upenn-embedded/final-project-website-submission-f25-t24-f25-team-1-team_name/chess.X/queuelogs/debugtool.txt

1676 1764451541629 GEN4_TO_CONTROLLER_LOG:GEN4_CONNECT_INT_LOG Payload End
1676 1764451541629 NativeController::GetFirmwareInfo entry
1676 1764451541629 pro JtagIce3 [0x01] <<< 02 00 00 00 01 
1676 1764451541645 pro JtagIce3 [0x01] >>> 84 01 00 00 
1676 1764451541645 NativeController::getFirmwareVersion entry
1676 1764451541645 pro JtagIce3 [0x01] <<< 02 00 00 01 01 
1676 1764451541661 pro JtagIce3 [0x01] >>> 84 01 01 00 
1676 1764451541661 pro JtagIce3 [0x01] <<< 02 00 00 02 01 
1676 1764451541677 pro JtagIce3 [0x01] >>> 84 01 16 00 
1676 1764451541677 pro JtagIce3 [0x01] <<< 02 00 00 03 02 
1676 1764451541693 pro JtagIce3 [0x01] >>> 84 01 86 00 00 
1676 1764451541693 NativeController::getFirmwareVersion exit
1676 1764451541693 pro JtagIce3 [0x01] <<< 02 00 00 09 01 
1676 1764451541710 pro JtagIce3 [0x01] >>> 84 01 FF 00 
1676 1764451541710 NativeController::tryGetFPGAVersion entry
1676 1764451541710 pro JtagIce3 [0x01] <<< 02 00 00 10 01 
1676 1764451541726 pro JtagIce3 [0x01] >>> 84 01 00 11 
1676 1764451541726 pro JtagIce3 [0x01] <<< 02 00 00 11 01 
1676 1764451541741 pro JtagIce3 [0x01] >>> 84 01 00 11 
1676 1764451541741 pro JtagIce3 [0x01] <<< 02 00 00 12 01 
1676 1764451541758 pro JtagIce3 [0x01] >>> 84 01 00 11 
1676 1764451541758 NativeController::tryGetFPGAVersion exit
1676 1764451541758 NativeController::tryGetFPGAVersion exit with exception No value present
1676 1764451541758 pro JtagIce3 [0x01] <<< 02 00 00 06 01 
1676 1764451541774 pro JtagIce3 [0x01] >>> 84 01 01 00 
1676 1764451541774 pro JtagIce3 [0x01] <<< 02 00 00 07 01 
1676 1764451541790 pro JtagIce3 [0x01] >>> 84 01 00 00 
1676 1764451541790 pro JtagIce3 [0x01] <<< 02 00 00 0A 01 
1676 1764451541806 pro JtagIce3 [0x01] >>> 84 01 00 11 
1676 1764451541806 NativeController::GetFirmwareInfo exit
1676 1764451541806 GEN4_TO_CONTROLLER_LOG:GEN4_CONNECT_INT_LOG Post:GetFirmwareInfo
1676 1764451541806 GEN4_TO_CONTROLLER_LOG:GEN4_CONNECT_INT_LOG Return Value
1676 1764451541806 GEN4_TO_CONTROLLER_LOG:GEN4_CONNECT_INT_LOG FirmwareInfo: Values:
1676 1764451541806 GEN4_TO_CONTROLLER_LOG:GEN4_CONNECT_INT_LOG FirmwareInfo: boot = false, bootVer = 1.0.0 (0x01.0x00.0x00), apVer = 1.22.134 (0x01.0x16.0x86), fpgaVer = null, scriptVer = null, macAddress = , devID = 0, devID1 = 0, devSN0 = 0, devSN1 = 0, serialNumber = null, appCommitID = null, scriptCommitID = null, PCB_ID = 0
1676 1764451541806 GEN4_TO_CONTROLLER_LOG:GEN4_CONNECT_INT_LOG Return End
1676 1764451541806 GEN4_CONNECT_DIAGNOSTICS:ENTERING: com.microchip.mplab.mdbcore.RI4Tool.ConnectionHandler.CheckForFWUpdates()
1676 1764451541806 GEN4_CONNECT_DIAGNOSTICS:Created FirmwareUpdateHandler com.microchip.mplab.mdbcore.AtmelIceScripting.OperationHandlers.AIceScriptingFirmwareUpdateHandler@eac0c85

1676 1764451541811 GEN4_TO_CONTROLLER_LOG:GEN4_CONNECT_INT_LOG Pre:SetUpdateFirmwareInfo
1676 1764451541811 GEN4_TO_CONTROLLER_LOG:GEN4_CONNECT_INT_LOG Payload
1676 1764451541811 GEN4_TO_CONTROLLER_LOG:GEN4_CONNECT_INT_LOG UpdateFirmwareInfo: Values:
1676 1764451541811 GEN4_TO_CONTROLLER_LOG:GEN4_CONNECT_INT_LOG UpdateFirmwareInfo: license = , updateId = 255
1676 1764451541811 GEN4_TO_CONTROLLER_LOG:GEN4_CONNECT_INT_LOG Payload End
1676 1764451541811 GEN4_TO_CONTROLLER_LOG:GEN4_CONNECT_INT_LOG Post:SetUpdateFirmwareInfo
1676 1764451541811 GEN4_TO_CONTROLLER_LOG:GEN4_CONNECT_INT_LOG Return Value
1676 1764451541811 GEN4_TO_CONTROLLER_LOG:GEN4_CONNECT_INT_LOG none
1676 1764451541811 GEN4_TO_CONTROLLER_LOG:GEN4_CONNECT_INT_LOG Return End
1676 1764451541811 GEN4_CONNECT_DIAGNOSTICS:EXITING: com.microchip.mplab.mdbcore.RI4Tool.ConnectionHandler.CheckForFWUpdates()

1676 1764451541811 GEN4_TO_CONTROLLER_LOG:GEN4_CONNECT_INT_LOG Pre:SetPowerInfo
1676 1764451541811 GEN4_TO_CONTROLLER_LOG:GEN4_CONNECT_INT_LOG Payload
1676 1764451541811 GEN4_TO_CONTROLLER_LOG:GEN4_CONNECT_INT_LOG PowerInfo: Values:
1676 1764451541812 GEN4_TO_CONTROLLER_LOG:GEN4_CONNECT_INT_LOG PowerInfo: shotDownSystem = false, isToolPower = false, voltage = 5.000000, useVppFirst = false, useLowVoltageProgramming = true, useMaintainActivePower = false
1676 1764451541812 GEN4_TO_CONTROLLER_LOG:GEN4_CONNECT_INT_LOG Payload End
1676 1764451541812 NativeController::GetVoltageInfo entry
1676 1764451541812 pro JtagIce3 [0x01] <<< 02 00 01 00 02 
1676 1764451541830 pro JtagIce3 [0x01] >>> 84 01 88 13 00 
1676 1764451541830 pro JtagIce3 [0x01] <<< 02 00 01 20 02 
1676 1764451541845 pro JtagIce3 [0x01] >>> 84 01 00 00 11 
1676 1764451541845 NativeController::GetVoltageInfo TSUP exit with exception + The requested command is not supported. (17)
1676 1764451541845 pro JtagIce3 [0x01] <<< 02 00 01 02 02 
1676 1764451541861 pro JtagIce3 [0x01] >>> 84 01 00 00 11 
1676 1764451541861 NativeController::GetVoltageInfo VUSB exit with exception + The requested command is not supported. (17)
1676 1764451541861 NativeController::GetVoltageInfo exit
1676 1764451541861 GEN4_TO_CONTROLLER_LOG:GEN4_CONNECT_INT_LOG Post:SetPowerInfo
1676 1764451541861 GEN4_TO_CONTROLLER_LOG:GEN4_CONNECT_INT_LOG Return Value
1676 1764451541861 GEN4_TO_CONTROLLER_LOG:GEN4_CONNECT_INT_LOG none
1676 1764451541861 GEN4_TO_CONTROLLER_LOG:GEN4_CONNECT_INT_LOG Return End

1676 1764451541861 GEN4_TO_CONTROLLER_LOG:GEN4_CONNECT_INT_LOG Pre:GetVoltageInfo
1676 1764451541861 GEN4_TO_CONTROLLER_LOG:GEN4_CONNECT_INT_LOG Payload
1676 1764451541861 GEN4_TO_CONTROLLER_LOG:GEN4_CONNECT_INT_LOG null
1676 1764451541861 GEN4_TO_CONTROLLER_LOG:GEN4_CONNECT_INT_LOG Payload End
1676 1764451541861 NativeController::GetVoltageInfo entry
1676 1764451541861 pro JtagIce3 [0x01] <<< 02 00 01 00 02 
1676 1764451541877 pro JtagIce3 [0x01] >>> 84 01 88 13 00 
1676 1764451541877 pro JtagIce3 [0x01] <<< 02 00 01 20 02 
1676 1764451541894 pro JtagIce3 [0x01] >>> 84 01 00 00 11 
1676 1764451541894 NativeController::GetVoltageInfo TSUP exit with exception + The requested command is not supported. (17)
1676 1764451541894 pro JtagIce3 [0x01] <<< 02 00 01 02 02 
1676 1764451541909 pro JtagIce3 [0x01] >>> 84 01 00 00 11 
1676 1764451541909 NativeController::GetVoltageInfo VUSB exit with exception + The requested command is not supported. (17)
1676 1764451541909 NativeController::GetVoltageInfo exit
1676 1764451541909 GEN4_TO_CONTROLLER_LOG:GEN4_CONNECT_INT_LOG Post:GetVoltageInfo
1676 1764451541909 GEN4_TO_CONTROLLER_LOG:GEN4_CONNECT_INT_LOG Return Value
1676 1764451541909 GEN4_TO_CONTROLLER_LOG:GEN4_CONNECT_INT_LOG VoltagesInfo: Values:
1676 1764451541909 GEN4_TO_CONTROLLER_LOG:GEN4_CONNECT_INT_LOG VoltagesInfo: internalVdd = 0, internalVpp = 0, targetVdd = 0, targetVpp = -2147483648, vddSense = 5000, temp = 0, vddCurrentSense = 0, vddVoltageSense = -2147483648
1676 1764451541909 GEN4_TO_CONTROLLER_LOG:GEN4_CONNECT_INT_LOG Return End

1676 1764451541909 GEN4_TO_CONTROLLER_LOG:GEN4_CONNECT_INT_LOG Pre:SetLEDBrightness
1676 1764451541909 GEN4_TO_CONTROLLER_LOG:GEN4_CONNECT_INT_LOG Payload
1676 1764451541909 GEN4_TO_CONTROLLER_LOG:GEN4_CONNECT_INT_LOG 5
1676 1764451541909 GEN4_TO_CONTROLLER_LOG:GEN4_CONNECT_INT_LOG Payload End
1676 1764451541909 GEN4_TO_CONTROLLER_LOG:GEN4_CONNECT_INT_LOG Post:SetLEDBrightness
1676 1764451541909 GEN4_TO_CONTROLLER_LOG:GEN4_CONNECT_INT_LOG Return Value
1676 1764451541909 GEN4_TO_CONTROLLER_LOG:GEN4_CONNECT_INT_LOG none
1676 1764451541909 GEN4_TO_CONTROLLER_LOG:GEN4_CONNECT_INT_LOG Return End

1676 1764451541909 GEN4_TO_CONTROLLER_LOG:GEN4_CONNECT_INT_LOG Pre:SetToolInfo
1676 1764451541909 GEN4_TO_CONTROLLER_LOG:GEN4_CONNECT_INT_LOG Payload
1676 1764451541909 GEN4_TO_CONTROLLER_LOG:GEN4_CONNECT_INT_LOG ToolInfo: Values:
1676 1764451541909 GEN4_TO_CONTROLLER_LOG:GEN4_CONNECT_INT_LOG ToolInfo: speedLevel = 1, PGCResistance = 4700, PGDResistance = 4700, PGCPullDir = PullDown, PGDPullDir = PullDown, ICSPSelected = Wire2
1676 1764451541909 GEN4_TO_CONTROLLER_LOG:GEN4_CONNECT_INT_LOG Payload End
1676 1764451541909 GEN4_TO_CONTROLLER_LOG:GEN4_CONNECT_INT_LOG Post:SetToolInfo
1676 1764451541909 GEN4_TO_CONTROLLER_LOG:GEN4_CONNECT_INT_LOG Return Value
1676 1764451541909 GEN4_TO_CONTROLLER_LOG:GEN4_CONNECT_INT_LOG none
1676 1764451541909 GEN4_TO_CONTROLLER_LOG:GEN4_CONNECT_INT_LOG Return End

1676 1764451541910 GEN4_TO_CONTROLLER_LOG:GEN4_CONNECT_INT_LOG Pre:GetTargetIDInfo
1676 1764451541910 GEN4_TO_CONTROLLER_LOG:GEN4_CONNECT_INT_LOG Payload
1676 1764451541910 GEN4_TO_CONTROLLER_LOG:GEN4_CONNECT_INT_LOG null
1676 1764451541910 GEN4_TO_CONTROLLER_LOG:GEN4_CONNECT_INT_LOG Payload End
1676 1764451541910 NativeController::GetTargetIDInfo entry
1676 1764451541910 pro JtagIce3 [0x12] <<< 01 00 00 00 01 01 
1676 1764451541925 pro JtagIce3 [0x12] >>> 80 00 
1676 1764451541925 pro JtagIce3 [0x12] <<< 01 00 00 01 04 01 00 00 00 
1676 1764451541941 pro JtagIce3 [0x12] >>> 80 00 
1676 1764451541941 pro JtagIce3 [0x12] <<< 01 00 01 00 01 01 
1676 1764451541958 pro JtagIce3 [0x12] >>> 80 00 
1676 1764451541958 pro JtagIce3 [0x11] <<< 1D 7D 00 
1676 1764451541974 pro JtagIce3 [0x11] >>> 1D 00 
1676 1764451541974 pro JtagIce3 [0x11] <<< 10 C8 64 19 20 00 53 03 AC 53 00 00 
1676 1764451542077 pro JtagIce3 [0x11] >>> 10 00 
1676 1764451542077 pro JtagIce3 [0x11] <<< 1B 04 30 00 00 00 
1676 1764451542094 pro JtagIce3 [0x11] >>> 1B 00 1E 00 
1676 1764451542094 pro JtagIce3 [0x11] <<< 1B 04 30 00 01 00 
1676 1764451542110 pro JtagIce3 [0x11] >>> 1B 00 95 00 
1676 1764451542110 pro JtagIce3 [0x11] <<< 1B 04 30 00 02 00 
1676 1764451542125 pro JtagIce3 [0x11] >>> 1B 00 16 00 
1676 1764451542125 pro JtagIce3 [0x11] <<< 1B 04 30 00 00 00 
1676 1764451542141 pro JtagIce3 [0x11] >>> 1B 00 1E 00 
1676 1764451542141 pro JtagIce3 [0x11] <<< 1B 04 30 00 01 00 
1676 1764451542158 pro JtagIce3 [0x11] >>> 1B 00 95 00 
1676 1764451542158 pro JtagIce3 [0x11] <<< 1B 04 30 00 02 00 
1676 1764451542173 pro JtagIce3 [0x11] >>> 1B 00 16 00 
1676 1764451542173 pro JtagIce3 [0x11] <<< 1B 04 30 00 00 00 
1676 1764451542190 pro JtagIce3 [0x11] >>> 1B 00 1E 00 
1676 1764451542190 pro JtagIce3 [0x11] <<< 1B 04 30 00 01 00 
1676 1764451542206 pro JtagIce3 [0x11] >>> 1B 00 95 00 
1676 1764451542206 pro JtagIce3 [0x11] <<< 1B 04 30 00 02 00 
1676 1764451542222 pro JtagIce3 [0x11] >>> 1B 00 16 00 
1676 1764451542222 pro JtagIce3 [0x11] <<< 11 01 01 
1676 1764451542238 pro JtagIce3 [0x11] >>> 11 00 
1676 1764451542238 pro JtagIce3 [0x01] <<< 11 00 00 
1676 1764451542254 pro JtagIce3 [0x01] >>> 80 00 
1676 1764451542254 NativeController::GetTargetIDInfo exit device ID 0x1e9516
1676 1764451542254 GEN4_TO_CONTROLLER_LOG:GEN4_CONNECT_INT_LOG Post:GetTargetIDInfo
1676 1764451542254 GEN4_TO_CONTROLLER_LOG:GEN4_CONNECT_INT_LOG Return Value
1676 1764451542254 GEN4_TO_CONTROLLER_LOG:GEN4_CONNECT_INT_LOG TargetIDInfo: Values:
1676 1764451542254 GEN4_TO_CONTROLLER_LOG:GEN4_CONNECT_INT_LOG TargetIDInfo: DeviceID = 001e9516
1676 1764451542254 GEN4_TO_CONTROLLER_LOG:GEN4_CONNECT_INT_LOG Return End

1676 1764451542260 GEN4_TO_CONTROLLER_LOG:GEN4_PROGRAM_INT_LOG_ATmega328PB Pre:SendOperation
1676 1764451542260 GEN4_TO_CONTROLLER_LOG:GEN4_PROGRAM_INT_LOG_ATmega328PB Payload
1676 1764451542260 GEN4_TO_CONTROLLER_LOG:GEN4_PROGRAM_INT_LOG_ATmega328PB OperationInfo: Values:
1676 1764451542260 GEN4_TO_CONTROLLER_LOG:GEN4_PROGRAM_INT_LOG_ATmega328PB OperationInfo: Type = erase, Mask = 00000000, Erase = false, Production Mode = true
1676 1764451542260 GEN4_TO_CONTROLLER_LOG:GEN4_PROGRAM_INT_LOG_ATmega328PB TransferInfo: Start = 0, End = 7fff, Buffer Length = 0, Type = Pgm, Mask = 00000000
1676 1764451542260 GEN4_TO_CONTROLLER_LOG:GEN4_PROGRAM_INT_LOG_ATmega328PB TransferInfo: Start = 820000, End = 820002, Buffer Length = 0, Type = Cfg, Mask = 00000000
1676 1764451542260 GEN4_TO_CONTROLLER_LOG:GEN4_PROGRAM_INT_LOG_ATmega328PB TransferInfo: Start = 830000, End = 830000, Buffer Length = 0, Type = Cfg, Mask = 00000000
1676 1764451542260 GEN4_TO_CONTROLLER_LOG:GEN4_PROGRAM_INT_LOG_ATmega328PB TransferInfo: Start = 0, End = 3ff, Buffer Length = 0, Type = DataFlash, Mask = 00000000
1676 1764451542260 GEN4_TO_CONTROLLER_LOG:GEN4_PROGRAM_INT_LOG_ATmega328PB Payload End
1676 1764451542260 pro JtagIce3 [0x12] <<< 01 00 00 00 01 01 
1676 1764451542277 pro JtagIce3 [0x12] >>> 80 00 
1676 1764451542277 pro JtagIce3 [0x12] <<< 01 00 00 01 04 01 00 00 00 
1676 1764451542293 pro JtagIce3 [0x12] >>> 80 00 
1676 1764451542293 pro JtagIce3 [0x12] <<< 01 00 01 00 01 01 
1676 1764451542309 pro JtagIce3 [0x12] >>> 80 00 
1676 1764451542309 pro JtagIce3 [0x11] <<< 1D 7D 00 
1676 1764451542325 pro JtagIce3 [0x11] >>> 1D 00 
1676 1764451542325 pro JtagIce3 [0x11] <<< 10 C8 64 19 20 00 53 03 AC 53 00 00 
1676 1764451542430 pro JtagIce3 [0x11] >>> 10 00 
1676 1764451542430 pro JtagIce3 [0x11] <<< 1B 04 30 00 00 00 
1676 1764451542445 pro JtagIce3 [0x11] >>> 1B 00 1E 00 
1676 1764451542445 pro JtagIce3 [0x11] <<< 1B 04 30 00 01 00 
1676 1764451542461 pro JtagIce3 [0x11] >>> 1B 00 95 00 
1676 1764451542461 pro JtagIce3 [0x11] <<< 1B 04 30 00 02 00 
1676 1764451542477 pro JtagIce3 [0x11] >>> 1B 00 16 00 
1676 1764451542477 pro JtagIce3 [0x11] <<< 12 2D 01 AC 80 00 00 
1676 1764451542493 pro JtagIce3 [0x11] >>> 12 00 
1676 1764451542493 pro JtagIce3 [0x11] <<< 18 04 58 08 00 00 
1676 1764451542509 pro JtagIce3 [0x11] >>> 18 00 DF 00 
1676 1764451542560 pro JtagIce3 [0x11] <<< 17 AC A8 00 DF 
1676 1764451542573 pro JtagIce3 [0x11] >>> 17 00 
1676 1764451542599 pro JtagIce3 [0x11] <<< 12 2D 01 AC 80 00 00 
1676 1764451542613 pro JtagIce3 [0x11] >>> 12 00 
1676 1764451542613 GEN4_TO_CONTROLLER_LOG:GEN4_PROGRAM_INT_LOG_ATmega328PB Post:SendOperation
1676 1764451542613 GEN4_TO_CONTROLLER_LOG:GEN4_PROGRAM_INT_LOG_ATmega328PB Return Value
1676 1764451542613 GEN4_TO_CONTROLLER_LOG:GEN4_PROGRAM_INT_LOG_ATmega328PB None
1676 1764451542613 GEN4_TO_CONTROLLER_LOG:GEN4_PROGRAM_INT_LOG_ATmega328PB Return End

1676 1764451542614 GEN4_TO_CONTROLLER_LOG:GEN4_PROGRAM_INT_LOG_ATmega328PB Pre:SendOperation
1676 1764451542614 GEN4_TO_CONTROLLER_LOG:GEN4_PROGRAM_INT_LOG_ATmega328PB Payload
1676 1764451542614 GEN4_TO_CONTROLLER_LOG:GEN4_PROGRAM_INT_LOG_ATmega328PB OperationInfo: Values:
1676 1764451542614 GEN4_TO_CONTROLLER_LOG:GEN4_PROGRAM_INT_LOG_ATmega328PB OperationInfo: Type = write, Mask = 00000000, Erase = false, Production Mode = true
1676 1764451542614 GEN4_TO_CONTROLLER_LOG:GEN4_PROGRAM_INT_LOG_ATmega328PB TransferInfo: Start = 0, End = 1d7f, Buffer Length = 7552, Type = Pgm, Mask = 00000000
1676 1764451542614 GEN4_TO_CONTROLLER_LOG:GEN4_PROGRAM_INT_LOG_ATmega328PB Payload End
1676 1764451542614 pro JtagIce3 [0x11] <<< 06 00 00 00 00 
1676 1764451542629 pro JtagIce3 [0x11] >>> 06 00 
1676 1764451542629 pro JtagIce3 [0x11] <<< 13 00 80 C1 0A 40 4C 20 00 00 0C 94 7B 00 0C 94 78 0C 0C 94 89 0C 0C 94 55 0D 0C 94 55 0D 0C 94 55 0D 0C 94 55 0D 0C 94 55 0D 0C 94 55 0D 0C 94 55 0D 0C 94 55 0D 0C 94 3B 09 0C 94 55 0D 0C 94 55 0D 0C 94 55 0D 0C 94 55 0D 0C 94 55 0D 0C 94 55 0D 0C 94 55 0D 0C 94 55 0D 0C 94 55 0D 0C 94 55 0D 0C 94 55 0D 0C 94 55 0D 0C 94 55 0D 0C 94 55 0D 0C 94 55 0D 0C 94 55 0D 0C 94 55 0D 0C 94 55 0D 0C 94 55 0D 0C 94 55 0D 
1676 1764451542732 pro JtagIce3 [0x11] >>> 13 00 
1676 1764451542732 pro JtagIce3 [0x11] <<< 06 00 00 00 40 
1676 1764451542748 pro JtagIce3 [0x11] >>> 06 00 
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
1676 1764451556590 GEN4_TO_CONTROLLER_LOG:GEN4_PROGRAM_INT_LOG_ATmega328PB Return Value
1676 1764451556590 GEN4_TO_CONTROLLER_LOG:GEN4_PROGRAM_INT_LOG_ATmega328PB None
1676 1764451556590 GEN4_TO_CONTROLLER_LOG:GEN4_PROGRAM_INT_LOG_ATmega328PB Return End

1676 1764451556590 GEN4_TO_CONTROLLER_LOG:GEN4_PROGRAM_INT_LOG_ATmega328PB Pre:endOfOperations
1676 1764451556590 GEN4_TO_CONTROLLER_LOG:GEN4_PROGRAM_INT_LOG_ATmega328PB Payload
1676 1764451556590 GEN4_TO_CONTROLLER_LOG:GEN4_PROGRAM_INT_LOG_ATmega328PB null
1676 1764451556590 GEN4_TO_CONTROLLER_LOG:GEN4_PROGRAM_INT_LOG_ATmega328PB Payload End
1676 1764451556590 pro JtagIce3 [0x11] <<< 11 01 01 
1676 1764451556605 pro JtagIce3 [0x11] >>> 11 00 
1676 1764451556605 pro JtagIce3 [0x01] <<< 11 00 00 
1676 1764451556622 pro JtagIce3 [0x01] >>> 80 00 
1676 1764451556622 GEN4_TO_CONTROLLER_LOG:GEN4_PROGRAM_INT_LOG_ATmega328PB Post:endOfOperations
1676 1764451556622 GEN4_TO_CONTROLLER_LOG:GEN4_PROGRAM_INT_LOG_ATmega328PB Return Value
1676 1764451556622 GEN4_TO_CONTROLLER_LOG:GEN4_PROGRAM_INT_LOG_ATmega328PB None
1676 1764451556622 GEN4_TO_CONTROLLER_LOG:GEN4_PROGRAM_INT_LOG_ATmega328PB Return End

1676 1764451556623 GEN4_TO_CONTROLLER_LOG:GEN4_PROGRAM_INT_LOG_ATmega328PB Pre:SendOperation
1676 1764451556623 GEN4_TO_CONTROLLER_LOG:GEN4_PROGRAM_INT_LOG_ATmega328PB Payload
1676 1764451556623 GEN4_TO_CONTROLLER_LOG:GEN4_PROGRAM_INT_LOG_ATmega328PB OperationInfo: Values:
1676 1764451556623 GEN4_TO_CONTROLLER_LOG:GEN4_PROGRAM_INT_LOG_ATmega328PB OperationInfo: Type = releasefromreset, Mask = 00000000, Erase = false, Production Mode = true
1676 1764451556623 GEN4_TO_CONTROLLER_LOG:GEN4_PROGRAM_INT_LOG_ATmega328PB Payload End
1676 1764451556623 pro JtagIce3 [0x01] <<< 11 00 00 
1676 1764451556638 pro JtagIce3 [0x01] >>> 80 00 
1676 1764451556638 GEN4_TO_CONTROLLER_LOG:GEN4_PROGRAM_INT_LOG_ATmega328PB Post:SendOperation
1676 1764451556638 GEN4_TO_CONTROLLER_LOG:GEN4_PROGRAM_INT_LOG_ATmega328PB Return Value
1676 1764451556638 GEN4_TO_CONTROLLER_LOG:GEN4_PROGRAM_INT_LOG_ATmega328PB None
1676 1764451556638 GEN4_TO_CONTROLLER_LOG:GEN4_PROGRAM_INT_LOG_ATmega328PB Return End
1676 1764451556638 GEN4_CONNECT_DIAGNOSTICS:MPLABCommTool is null

1676 1764451556638 GEN4_TO_CONTROLLER_LOG:GEN4_CONNECT_INT_LOG Pre:GetFirmwareInfo
1676 1764451556638 GEN4_TO_CONTROLLER_LOG:GEN4_CONNECT_INT_LOG Payload
1676 1764451556638 GEN4_TO_CONTROLLER_LOG:GEN4_CONNECT_INT_LOG null
1676 1764451556638 GEN4_TO_CONTROLLER_LOG:GEN4_CONNECT_INT_LOG Payload End
1676 1764451556638 NativeController::GetFirmwareInfo entry
1676 1764451556638 pro JtagIce3 [0x01] <<< 02 00 00 00 01 
1676 1764451556654 pro JtagIce3 [0x01] >>> 84 01 00 00 
1676 1764451556654 NativeController::getFirmwareVersion entry
1676 1764451556654 pro JtagIce3 [0x01] <<< 02 00 00 01 01 
1676 1764451556669 pro JtagIce3 [0x01] >>> 84 01 01 00 
1676 1764451556669 pro JtagIce3 [0x01] <<< 02 00 00 02 01 
1676 1764451556686 pro JtagIce3 [0x01] >>> 84 01 16 00 
1676 1764451556686 pro JtagIce3 [0x01] <<< 02 00 00 03 02 
1676 1764451556702 pro JtagIce3 [0x01] >>> 84 01 86 00 00 
1676 1764451556702 NativeController::getFirmwareVersion exit
1676 1764451556702 pro JtagIce3 [0x01] <<< 02 00 00 09 01 
1676 1764451556717 pro JtagIce3 [0x01] >>> 84 01 FF 00 
1676 1764451556717 NativeController::tryGetFPGAVersion entry
1676 1764451556717 pro JtagIce3 [0x01] <<< 02 00 00 10 01 
1676 1764451556733 pro JtagIce3 [0x01] >>> 84 01 00 11 
1676 1764451556733 pro JtagIce3 [0x01] <<< 02 00 00 11 01 
1676 1764451556749 pro JtagIce3 [0x01] >>> 84 01 00 11 
1676 1764451556749 pro JtagIce3 [0x01] <<< 02 00 00 12 01 
1676 1764451556765 pro JtagIce3 [0x01] >>> 84 01 00 11 
1676 1764451556765 NativeController::tryGetFPGAVersion exit
1676 1764451556765 NativeController::tryGetFPGAVersion exit with exception No value present
1676 1764451556765 pro JtagIce3 [0x01] <<< 02 00 00 06 01 
1676 1764451556782 pro JtagIce3 [0x01] >>> 84 01 01 00 
1676 1764451556782 pro JtagIce3 [0x01] <<< 02 00 00 07 01 
1676 1764451556798 pro JtagIce3 [0x01] >>> 84 01 00 00 
1676 1764451556798 pro JtagIce3 [0x01] <<< 02 00 00 0A 01 
1676 1764451556813 pro JtagIce3 [0x01] >>> 84 01 00 11 
1676 1764451556814 NativeController::GetFirmwareInfo exit
1676 1764451556814 GEN4_TO_CONTROLLER_LOG:GEN4_CONNECT_INT_LOG Post:GetFirmwareInfo
1676 1764451556814 GEN4_TO_CONTROLLER_LOG:GEN4_CONNECT_INT_LOG Return Value
1676 1764451556814 GEN4_TO_CONTROLLER_LOG:GEN4_CONNECT_INT_LOG FirmwareInfo: Values:
1676 1764451556814 GEN4_TO_CONTROLLER_LOG:GEN4_CONNECT_INT_LOG FirmwareInfo: boot = false, bootVer = 1.0.0 (0x01.0x00.0x00), apVer = 1.22.134 (0x01.0x16.0x86), fpgaVer = null, scriptVer = null, macAddress = , devID = 0, devID1 = 0, devSN0 = 0, devSN1 = 0, serialNumber = null, appCommitID = null, scriptCommitID = null, PCB_ID = 0
1676 1764451556814 GEN4_TO_CONTROLLER_LOG:GEN4_CONNECT_INT_LOG Return End

1676 1764451556814 GEN4_TO_CONTROLLER_LOG:GEN4_CONNECT_INT_LOG Pre:SetPowerInfo
1676 1764451556814 GEN4_TO_CONTROLLER_LOG:GEN4_CONNECT_INT_LOG Payload
1676 1764451556814 GEN4_TO_CONTROLLER_LOG:GEN4_CONNECT_INT_LOG PowerInfo: Values:
1676 1764451556814 GEN4_TO_CONTROLLER_LOG:GEN4_CONNECT_INT_LOG PowerInfo: shotDownSystem = true, isToolPower = false, voltage = 0.000000, useVppFirst = false, useLowVoltageProgramming = true, useMaintainActivePower = false
1676 1764451556814 GEN4_TO_CONTROLLER_LOG:GEN4_CONNECT_INT_LOG Payload End
1676 1764451556814 NativeController::GetVoltageInfo entry
1676 1764451556814 pro JtagIce3 [0x01] <<< 02 00 01 00 02 
1676 1764451556830 pro JtagIce3 [0x01] >>> 84 01 88 13 00 
1676 1764451556830 pro JtagIce3 [0x01] <<< 02 00 01 20 02 
1676 1764451556846 pro JtagIce3 [0x01] >>> 84 01 00 00 11 
1676 1764451556846 NativeController::GetVoltageInfo TSUP exit with exception + The requested command is not supported. (17)
1676 1764451556846 pro JtagIce3 [0x01] <<< 02 00 01 02 02 
1676 1764451556861 pro JtagIce3 [0x01] >>> 84 01 00 00 11 
1676 1764451556861 NativeController::GetVoltageInfo VUSB exit with exception + The requested command is not supported. (17)
1676 1764451556861 NativeController::GetVoltageInfo exit
1676 1764451556861 GEN4_TO_CONTROLLER_LOG:GEN4_CONNECT_INT_LOG Post:SetPowerInfo
1676 1764451556861 GEN4_TO_CONTROLLER_LOG:GEN4_CONNECT_INT_LOG Return Value
1676 1764451556861 GEN4_TO_CONTROLLER_LOG:GEN4_CONNECT_INT_LOG none
1676 1764451556861 GEN4_TO_CONTROLLER_LOG:GEN4_CONNECT_INT_LOG Return End

1676 1764451556861 GEN4_TO_CONTROLLER_LOG:GEN4_CONNECT_INT_LOG Pre:Disconnect
1676 1764451556861 GEN4_TO_CONTROLLER_LOG:GEN4_CONNECT_INT_LOG Payload
1676 1764451556861 GEN4_TO_CONTROLLER_LOG:GEN4_CONNECT_INT_LOG Payload End
1676 1764451556861 NativeController::Disconnect entry
1676 1764451556861 pro JtagIce3 [0x01] <<< 11 00 00 
1676 1764451556878 pro JtagIce3 [0x01] >>> 80 00 
1676 1764451556878 NativeController::Disconnect exit
1676 1764451556878 GEN4_TO_CONTROLLER_LOG:GEN4_CONNECT_INT_LOG Post:Disconnect
1676 1764451556878 GEN4_TO_CONTROLLER_LOG:GEN4_CONNECT_INT_LOG Return Value
1676 1764451556878 GEN4_TO_CONTROLLER_LOG:GEN4_CONNECT_INT_LOG none
1676 1764451556878 GEN4_TO_CONTROLLER_LOG:GEN4_CONNECT_INT_LOG Return End
1676 1764451556878 GEN4_CONNECT_DIAGNOSTICS:Removing plug and play observer com.microchip.mplab.mdbcore.RI4Tool.RI4ToolBase$RI4PlugNPlayObserver@555a89df
1676 1764451556878 GEN4_CONNECT_DIAGNOSTICS:Begin PlugNPlayObservers list dump:
1676 1764451556878 GEN4_CONNECT_DIAGNOSTICS:End PlugNPlayObservers list dump:
1676 1764451556979 GEN4_CONNECT_DIAGNOSTICS:Calling RIDbgToolCom.Disconnect
1676 1764451556979 GEN4_CONNECT_DIAGNOSTICS:Calling MPLABCommTool.Detach to remove tool from plug and play list
1676 1764451556979 GEN4_CONNECT_DIAGNOSTICS:Calling RIDbgToolCom.DisconnectFromMPlabComm
1676 1764451556979 GEN4_CONNECT_DIAGNOSTICS:Calling MPLABCommTool.Disconnect
1722 1764452234338 GEN4_CONNECT_DIAGNOSTICS:MPLABCommTool is NOT null
1722 1764452234338 GEN4_CONNECT_DIAGNOSTICS:AttachedToolPID = 2145, AttachedToolVID = 3eb
1722 1764452234338 GEN4_CONNECT_DIAGNOSTICS:transport type = USB
1722 1764452234338 GEN4_CONNECT_DIAGNOSTICS:AttachedToolPID = 2145, AttachedToolVID = 3eb
1722 1764452234340 com.microchip.mplab.mdbcore.RealICETool.RIDbgToolCom
1722 1764452234340 GEN4_CONNECT_DIAGNOSTICS:Before MPLABCommTool.Connect()
1722 1764452234340 GEN4_CONNECT_DIAGNOSTICS:After MPLABCommTool.Connect()
1722 1764452234340 GEN4_CONNECT_DIAGNOSTICS:MPLABCommTool.Connect() returned MPLABCOMM_NO_ERROR
1722 1764452234340 GEN4_CONNECT_DIAGNOSTICS:Attaching to MPLABCommTool plugnplay
1722 1764452234340 GEN4_CONNECT_DIAGNOSTICS:Adding new plug and play observer com.microchip.mplab.mdbcore.RI4Tool.RI4ToolBase$RI4PlugNPlayObserver@fc8a47b
1722 1764452234340 GEN4_CONNECT_DIAGNOSTICS:Begin PlugNPlayObservers list dump:
1722 1764452234340 GEN4_CONNECT_DIAGNOSTICS:com.microchip.mplab.mdbcore.RI4Tool.RI4ToolBase$RI4PlugNPlayObserver@fc8a47b
1722 1764452234340 GEN4_CONNECT_DIAGNOSTICS:End PlugNPlayObservers list dump:
1722 1764452234340 GEN4_CONNECT_DIAGNOSTICS:Registering for alternate PNP notifications. CommPnPCriteria.cPIDList = [2ff4], CommPnPCriteria.cSerialNumber = atml2523052700011486

1722 1764452234355 GEN4_TO_CONTROLLER_LOG:GEN4_INIT_INT_LOG_ATmega328PB Pre:init
1722 1764452234355 GEN4_TO_CONTROLLER_LOG:GEN4_INIT_INT_LOG_ATmega328PB Payload
1722 1764452234355 GEN4_TO_CONTROLLER_LOG:GEN4_INIT_INT_LOG_ATmega328PB DeviceInfo: Values:
1722 1764452234355 GEN4_TO_CONTROLLER_LOG:GEN4_INIT_INT_LOG_ATmega328PB DeviceInfo: pcAddress = 7fffffffffffffff, Vpp = 5.00, useRowEraseIfVoltageIsLow = false, voltageBelowWhichUseRowErase = 0.00, deviceName = ATmega328PB, programmerType = 
1722 1764452234355 GEN4_TO_CONTROLLER_LOG:GEN4_INIT_INT_LOG_ATmega328PB DeviceInfo: MemInfo values:
1722 1764452234355 GEN4_TO_CONTROLLER_LOG:GEN4_INIT_INT_LOG_ATmega328PB DeviceInfo: mask = ffff, exists = true, startAddr = 00000000, endAddr = 00007fff, rowSize = 0080, rowEraseSize = 0080, addrInc = 0001, widthProgram = 0001
1722 1764452234355 GEN4_TO_CONTROLLER_LOG:GEN4_INIT_INT_LOG_ATmega328PB DeviceInfo: mask = 00ff, exists = true, startAddr = 00820000, endAddr = 00820002, rowSize = 0001, rowEraseSize = 0000, addrInc = 0001, widthProgram = 0001
1722 1764452234355 GEN4_TO_CONTROLLER_LOG:GEN4_INIT_INT_LOG_ATmega328PB DeviceInfo: mask = 0000, exists = false, startAddr = 00000000, endAddr = 00000000, rowSize = 0000, rowEraseSize = 0000, addrInc = 0000, widthProgram = 0000
1722 1764452234355 GEN4_TO_CONTROLLER_LOG:GEN4_INIT_INT_LOG_ATmega328PB DeviceInfo: mask = 0000, exists = false, startAddr = 00000000, endAddr = 00000000, rowSize = 0000, rowEraseSize = 0000, addrInc = 0000, widthProgram = 0000
1722 1764452234355 GEN4_TO_CONTROLLER_LOG:GEN4_INIT_INT_LOG_ATmega328PB DeviceInfo: mask = 0000, exists = false, startAddr = 00000000, endAddr = 00000000, rowSize = 0000, rowEraseSize = 0000, addrInc = 0000, widthProgram = 0000
1722 1764452234355 GEN4_TO_CONTROLLER_LOG:GEN4_INIT_INT_LOG_ATmega328PB DeviceInfo: mask = 0000, exists = false, startAddr = 00000000, endAddr = 00000000, rowSize = 0000, rowEraseSize = 0080, addrInc = 0000, widthProgram = 0000
1722 1764452234355 GEN4_TO_CONTROLLER_LOG:GEN4_INIT_INT_LOG_ATmega328PB DeviceInfo: mask = 0000, exists = false, startAddr = 00000000, endAddr = 00000000, rowSize = 0000, rowEraseSize = 0000, addrInc = 0001, widthProgram = 0001
1722 1764452234355 GEN4_TO_CONTROLLER_LOG:GEN4_INIT_INT_LOG_ATmega328PB DeviceInfo: mask = 0000, exists = false, startAddr = 00000000, endAddr = 00000000, rowSize = 0000, rowEraseSize = 0000, addrInc = 0000, widthProgram = 0000
1722 1764452234355 GEN4_TO_CONTROLLER_LOG:GEN4_INIT_INT_LOG_ATmega328PB DeviceInfo: mask = 00ff, exists = true, startAddr = 00000000, endAddr = 000003ff, rowSize = 0004, rowEraseSize = 0000, addrInc = 0001, widthProgram = 0001
1722 1764452234355 GEN4_TO_CONTROLLER_LOG:GEN4_INIT_INT_LOG_ATmega328PB DeviceInfo: mask = 0000, exists = false, startAddr = 00000000, endAddr = 00000000, rowSize = 0000, rowEraseSize = 0000, addrInc = 0000, widthProgram = 0000
1722 1764452234355 GEN4_TO_CONTROLLER_LOG:GEN4_INIT_INT_LOG_ATmega328PB DeviceInfo: mask = 0000, exists = false, startAddr = 00000000, endAddr = 00000000, rowSize = 0000, rowEraseSize = 0000, addrInc = 0000, widthProgram = 0000
1722 1764452234356 GEN4_TO_CONTROLLER_LOG:GEN4_INIT_INT_LOG_ATmega328PB DeviceInfo: mask = 0000, exists = false, startAddr = 00000000, endAddr = 00000000, rowSize = 0000, rowEraseSize = 0000, addrInc = 0001, widthProgram = 0001
1722 1764452234356 GEN4_TO_CONTROLLER_LOG:GEN4_INIT_INT_LOG_ATmega328PB DeviceInfo: mask = 0000, exists = false, startAddr = 00000000, endAddr = 00000000, rowSize = 0000, rowEraseSize = 0000, addrInc = 0000, widthProgram = 0000
1722 1764452234356 GEN4_TO_CONTROLLER_LOG:GEN4_INIT_INT_LOG_ATmega328PB DeviceInfo: mask = 0000, exists = false, startAddr = 00000000, endAddr = 00000000, rowSize = 0000, rowEraseSize = 0000, addrInc = 0000, widthProgram = 0000
1722 1764452234356 GEN4_TO_CONTROLLER_LOG:GEN4_INIT_INT_LOG_ATmega328PB DeviceInfo: mask = 0000, exists = false, startAddr = 00000000, endAddr = 00000000, rowSize = 0000, rowEraseSize = 0000, addrInc = 0000, widthProgram = 0000
1722 1764452234356 GEN4_TO_CONTROLLER_LOG:GEN4_INIT_INT_LOG_ATmega328PB DeviceInfo: mask = 0000, exists = false, startAddr = 00000000, endAddr = 00000000, rowSize = 0000, rowEraseSize = 0000, addrInc = 0000, widthProgram = 0000
1722 1764452234356 GEN4_TO_CONTROLLER_LOG:GEN4_INIT_INT_LOG_ATmega328PB DeviceInfo: mask = 7fffffff, exists = true, startAddr = 00840000, endAddr = 00840002, rowSize = 0001, rowEraseSize = 0000, addrInc = 0001, widthProgram = 0001
1722 1764452234356 GEN4_TO_CONTROLLER_LOG:GEN4_INIT_INT_LOG_ATmega328PB DeviceInfo: mask = 0000, exists = false, startAddr = 00000000, endAddr = 00000000, rowSize = 0000, rowEraseSize = 0000, addrInc = 0000, widthProgram = 0000
1722 1764452234356 GEN4_TO_CONTROLLER_LOG:GEN4_INIT_INT_LOG_ATmega328PB DeviceInfo: mask = 0000, exists = false, startAddr = 00000000, endAddr = 00000000, rowSize = 0000, rowEraseSize = 0000, addrInc = 0000, widthProgram = 0000
1722 1764452234356 GEN4_TO_CONTROLLER_LOG:GEN4_INIT_INT_LOG_ATmega328PB DeviceInfo: mask = 0000, exists = false, startAddr = 00000000, endAddr = 00000000, rowSize = 0000, rowEraseSize = 0000, addrInc = 0000, widthProgram = 0000
1722 1764452234356 GEN4_TO_CONTROLLER_LOG:GEN4_INIT_INT_LOG_ATmega328PB DeviceInfo: mask = 0000, exists = false, startAddr = 00000000, endAddr = 00000000, rowSize = 0000, rowEraseSize = 0000, addrInc = 0000, widthProgram = 0000
1722 1764452234356 GEN4_TO_CONTROLLER_LOG:GEN4_INIT_INT_LOG_ATmega328PB DeviceInfo: mask = 0000, exists = false, startAddr = 00000000, endAddr = 00000000, rowSize = 0000, rowEraseSize = 0000, addrInc = 0000, widthProgram = 0000
1722 1764452234356 GEN4_TO_CONTROLLER_LOG:GEN4_INIT_INT_LOG_ATmega328PB DeviceInfo: mask = 0000, exists = false, startAddr = 00000000, endAddr = 00000000, rowSize = 0000, rowEraseSize = 0000, addrInc = 0000, widthProgram = 0000
1722 1764452234356 GEN4_TO_CONTROLLER_LOG:GEN4_INIT_INT_LOG_ATmega328PB DeviceInfo: CfgRequiredBitsMask Values:
1722 1764452234356 GEN4_TO_CONTROLLER_LOG:GEN4_INIT_INT_LOG_ATmega328PB Address = 00820000, Mask = 000000ff
1722 1764452234356 GEN4_TO_CONTROLLER_LOG:GEN4_INIT_INT_LOG_ATmega328PB Address = 00820001, Mask = 000000ff
1722 1764452234356 GEN4_TO_CONTROLLER_LOG:GEN4_INIT_INT_LOG_ATmega328PB Address = 00820002, Mask = 0000000f
1722 1764452234356 GEN4_TO_CONTROLLER_LOG:GEN4_INIT_INT_LOG_ATmega328PB Address = 00830000, Mask = 0000003f
1722 1764452234356 GEN4_TO_CONTROLLER_LOG:GEN4_INIT_INT_LOG_ATmega328PB BasicInfo: Values:
1722 1764452234356 GEN4_TO_CONTROLLER_LOG:GEN4_INIT_INT_LOG_ATmega328PB Payload End
1722 1764452234356 GEN4_TO_CONTROLLER_LOG:GEN4_INIT_INT_LOG_ATmega328PB Post:init
1722 1764452234356 GEN4_TO_CONTROLLER_LOG:GEN4_INIT_INT_LOG_ATmega328PB Return Value
1722 1764452234356 GEN4_TO_CONTROLLER_LOG:GEN4_INIT_INT_LOG_ATmega328PB none
1722 1764452234356 GEN4_TO_CONTROLLER_LOG:GEN4_INIT_INT_LOG_ATmega328PB Return End

1722 1764452234356 GEN4_TO_CONTROLLER_LOG:GEN4_INIT_INT_LOG_ATmega328PB Pre:GetInterfaceProvider
1722 1764452234356 GEN4_TO_CONTROLLER_LOG:GEN4_INIT_INT_LOG_ATmega328PB Payload
1722 1764452234356 GEN4_TO_CONTROLLER_LOG:GEN4_INIT_INT_LOG_ATmega328PB RI4DebugInterface
1722 1764452234356 GEN4_TO_CONTROLLER_LOG:GEN4_INIT_INT_LOG_ATmega328PB Payload End
1722 1764452234356 GEN4_TO_CONTROLLER_LOG:GEN4_INIT_INT_LOG_ATmega328PB Post:GetInterfaceProvider
1722 1764452234356 GEN4_TO_CONTROLLER_LOG:GEN4_INIT_INT_LOG_ATmega328PB Return Value
1722 1764452234356 GEN4_TO_CONTROLLER_LOG:GEN4_INIT_INT_LOG_ATmega328PB com.microchip.mplab.libs.atmelice.implementations.DebugInterface@41a7d021
1722 1764452234356 GEN4_TO_CONTROLLER_LOG:GEN4_INIT_INT_LOG_ATmega328PB Return End

1722 1764452234356 GEN4_TO_CONTROLLER_LOG:GEN4_INIT_INT_LOG_ATmega328PB Pre:GetInterfaceProvider
1722 1764452234356 GEN4_TO_CONTROLLER_LOG:GEN4_INIT_INT_LOG_ATmega328PB Payload
1722 1764452234356 GEN4_TO_CONTROLLER_LOG:GEN4_INIT_INT_LOG_ATmega328PB RI4ProgramInterface
1722 1764452234356 GEN4_TO_CONTROLLER_LOG:GEN4_INIT_INT_LOG_ATmega328PB Payload End
1722 1764452234356 GEN4_TO_CONTROLLER_LOG:GEN4_INIT_INT_LOG_ATmega328PB Post:GetInterfaceProvider
1722 1764452234356 GEN4_TO_CONTROLLER_LOG:GEN4_INIT_INT_LOG_ATmega328PB Return Value
1722 1764452234356 GEN4_TO_CONTROLLER_LOG:GEN4_INIT_INT_LOG_ATmega328PB com.microchip.mplab.libs.atmelice.implementations.ProgramInterface@b865f12
1722 1764452234356 GEN4_TO_CONTROLLER_LOG:GEN4_INIT_INT_LOG_ATmega328PB Return End

1722 1764452234356 GEN4_TO_CONTROLLER_LOG:GEN4_INIT_INT_LOG_ATmega328PB Pre:GetInterfaceProvider
1722 1764452234356 GEN4_TO_CONTROLLER_LOG:GEN4_INIT_INT_LOG_ATmega328PB Payload
1722 1764452234356 GEN4_TO_CONTROLLER_LOG:GEN4_INIT_INT_LOG_ATmega328PB RI4ConnectInterface
1722 1764452234356 GEN4_TO_CONTROLLER_LOG:GEN4_INIT_INT_LOG_ATmega328PB Payload End
1722 1764452234356 GEN4_TO_CONTROLLER_LOG:GEN4_INIT_INT_LOG_ATmega328PB Post:GetInterfaceProvider
1722 1764452234356 GEN4_TO_CONTROLLER_LOG:GEN4_INIT_INT_LOG_ATmega328PB Return Value
1722 1764452234356 GEN4_TO_CONTROLLER_LOG:GEN4_INIT_INT_LOG_ATmega328PB com.microchip.mplab.libs.atmelice.implementations.ConnectInterface@39a58a79
1722 1764452234356 GEN4_TO_CONTROLLER_LOG:GEN4_INIT_INT_LOG_ATmega328PB Return End

1722 1764452234356 GEN4_TO_CONTROLLER_LOG:GEN4_INIT_INT_LOG_ATmega328PB Pre:GetInterfaceProvider
1722 1764452234356 GEN4_TO_CONTROLLER_LOG:GEN4_INIT_INT_LOG_ATmega328PB Payload
1722 1764452234356 GEN4_TO_CONTROLLER_LOG:GEN4_INIT_INT_LOG_ATmega328PB RI4ControllerDiagnosticsInterface
1722 1764452234356 GEN4_TO_CONTROLLER_LOG:GEN4_INIT_INT_LOG_ATmega328PB Payload End
1722 1764452234357 GEN4_TO_CONTROLLER_LOG:GEN4_INIT_INT_LOG_ATmega328PB Post:GetInterfaceProvider
1722 1764452234357 GEN4_TO_CONTROLLER_LOG:GEN4_INIT_INT_LOG_ATmega328PB Return Value
1722 1764452234357 GEN4_TO_CONTROLLER_LOG:GEN4_INIT_INT_LOG_ATmega328PB com.microchip.mplab.libs.atmelice.implementations.UnimplementedDiagnostics@2fd47ce2
1722 1764452234357 GEN4_TO_CONTROLLER_LOG:GEN4_INIT_INT_LOG_ATmega328PB Return End

1722 1764452234357 GEN4_TO_CONTROLLER_LOG:GEN4_INIT_INT_LOG_ATmega328PB Pre:GetInterfaceProvider
1722 1764452234357 GEN4_TO_CONTROLLER_LOG:GEN4_INIT_INT_LOG_ATmega328PB Payload
1722 1764452234357 GEN4_TO_CONTROLLER_LOG:GEN4_INIT_INT_LOG_ATmega328PB ProgrammerToGo
1722 1764452234357 GEN4_TO_CONTROLLER_LOG:GEN4_INIT_INT_LOG_ATmega328PB Payload End
1722 1764452234357 GEN4_TO_CONTROLLER_LOG:GEN4_INIT_INT_LOG_ATmega328PB Post:GetInterfaceProvider
1722 1764452234357 GEN4_TO_CONTROLLER_LOG:GEN4_INIT_INT_LOG_ATmega328PB Return Value
1722 1764452234357 GEN4_TO_CONTROLLER_LOG:GEN4_INIT_INT_LOG_ATmega328PB null
1722 1764452234357 GEN4_TO_CONTROLLER_LOG:GEN4_INIT_INT_LOG_ATmega328PB Return End

1722 1764452234357 GEN4_TO_CONTROLLER_LOG:GEN4_INIT_INT_LOG_ATmega328PB Pre:GetInterfaceProvider
1722 1764452234357 GEN4_TO_CONTROLLER_LOG:GEN4_INIT_INT_LOG_ATmega328PB Payload
1722 1764452234357 GEN4_TO_CONTROLLER_LOG:GEN4_INIT_INT_LOG_ATmega328PB Status
1722 1764452234357 GEN4_TO_CONTROLLER_LOG:GEN4_INIT_INT_LOG_ATmega328PB Payload End
1722 1764452234357 GEN4_TO_CONTROLLER_LOG:GEN4_INIT_INT_LOG_ATmega328PB Post:GetInterfaceProvider
1722 1764452234357 GEN4_TO_CONTROLLER_LOG:GEN4_INIT_INT_LOG_ATmega328PB Return Value
1722 1764452234357 GEN4_TO_CONTROLLER_LOG:GEN4_INIT_INT_LOG_ATmega328PB null
1722 1764452234357 GEN4_TO_CONTROLLER_LOG:GEN4_INIT_INT_LOG_ATmega328PB Return End

1722 1764452234359 GEN4_TO_CONTROLLER_LOG:GEN4_CONNECT_INT_LOG Pre:EstablishCommunincations
1722 1764452234359 GEN4_TO_CONTROLLER_LOG:GEN4_CONNECT_INT_LOG Payload
1722 1764452234359 GEN4_TO_CONTROLLER_LOG:GEN4_CONNECT_INT_LOG com.microchip.mplab.mdbcore.AtmelIceScripting.AIceScriptingCom@500d97e1
1722 1764452234359 GEN4_TO_CONTROLLER_LOG:GEN4_CONNECT_INT_LOG Payload End
1722 1764452234359 NativeController::EstablishCommunincations entry
1722 1764452234359 pro JtagIce3 [0x00] <<< 00 00 00 
1722 1764452234384 pro JtagIce3 [0x00] >>> 81 00 00 01 12 20 11 
1722 1764452234384 pro JtagIce3 [0x01] <<< 10 00 
1722 1764452234400 pro JtagIce3 [0x01] >>> 80 00 
1722 1764452234400 pro JtagIce3 [0x00] <<< 00 00 03 
1722 1764452234416 pro JtagIce3 [0x00] >>> 81 00 01 05 
1722 1764452234416 NativeController::EstablishCommunincations exit
1722 1764452234416 GEN4_TO_CONTROLLER_LOG:GEN4_CONNECT_INT_LOG Post:EstablishCommunincations
1722 1764452234416 GEN4_TO_CONTROLLER_LOG:GEN4_CONNECT_INT_LOG Return Value
1722 1764452234416 GEN4_TO_CONTROLLER_LOG:GEN4_CONNECT_INT_LOG true
1722 1764452234416 GEN4_TO_CONTROLLER_LOG:GEN4_CONNECT_INT_LOG Return End

1722 1764452234416 GEN4_TO_CONTROLLER_LOG:GEN4_CONNECT_INT_LOG Pre:GetFirmwareInfo
1722 1764452234416 GEN4_TO_CONTROLLER_LOG:GEN4_CONNECT_INT_LOG Payload
1722 1764452234416 GEN4_TO_CONTROLLER_LOG:GEN4_CONNECT_INT_LOG null
1722 1764452234416 GEN4_TO_CONTROLLER_LOG:GEN4_CONNECT_INT_LOG Payload End
1722 1764452234416 NativeController::GetFirmwareInfo entry
1722 1764452234416 pro JtagIce3 [0x01] <<< 02 00 00 00 01 
1722 1764452234432 pro JtagIce3 [0x01] >>> 84 01 00 00 
1722 1764452234432 NativeController::getFirmwareVersion entry
1722 1764452234432 pro JtagIce3 [0x01] <<< 02 00 00 01 01 
1722 1764452234447 pro JtagIce3 [0x01] >>> 84 01 01 00 
1722 1764452234447 pro JtagIce3 [0x01] <<< 02 00 00 02 01 
1722 1764452234463 pro JtagIce3 [0x01] >>> 84 01 16 00 
1722 1764452234463 pro JtagIce3 [0x01] <<< 02 00 00 03 02 
1722 1764452234479 pro JtagIce3 [0x01] >>> 84 01 86 00 00 
1722 1764452234479 NativeController::getFirmwareVersion exit
1722 1764452234479 pro JtagIce3 [0x01] <<< 02 00 00 09 01 
1722 1764452234495 pro JtagIce3 [0x01] >>> 84 01 FF 00 
1722 1764452234495 NativeController::tryGetFPGAVersion entry
1722 1764452234495 pro JtagIce3 [0x01] <<< 02 00 00 10 01 
1722 1764452234512 pro JtagIce3 [0x01] >>> 84 01 00 11 
1722 1764452234512 pro JtagIce3 [0x01] <<< 02 00 00 11 01 
1722 1764452234528 pro JtagIce3 [0x01] >>> 84 01 00 11 
1722 1764452234528 pro JtagIce3 [0x01] <<< 02 00 00 12 01 
1722 1764452234544 pro JtagIce3 [0x01] >>> 84 01 00 11 
1722 1764452234544 NativeController::tryGetFPGAVersion exit
1722 1764452234544 NativeController::tryGetFPGAVersion exit with exception No value present
1722 1764452234544 pro JtagIce3 [0x01] <<< 02 00 00 06 01 
1722 1764452234560 pro JtagIce3 [0x01] >>> 84 01 01 00 
1722 1764452234560 pro JtagIce3 [0x01] <<< 02 00 00 07 01 
1722 1764452234576 pro JtagIce3 [0x01] >>> 84 01 00 00 
1722 1764452234576 pro JtagIce3 [0x01] <<< 02 00 00 0A 01 
1722 1764452234592 pro JtagIce3 [0x01] >>> 84 01 00 11 
1722 1764452234592 NativeController::GetFirmwareInfo exit
1722 1764452234592 GEN4_TO_CONTROLLER_LOG:GEN4_CONNECT_INT_LOG Post:GetFirmwareInfo
1722 1764452234592 GEN4_TO_CONTROLLER_LOG:GEN4_CONNECT_INT_LOG Return Value
1722 1764452234592 GEN4_TO_CONTROLLER_LOG:GEN4_CONNECT_INT_LOG FirmwareInfo: Values:
1722 1764452234592 GEN4_TO_CONTROLLER_LOG:GEN4_CONNECT_INT_LOG FirmwareInfo: boot = false, bootVer = 1.0.0 (0x01.0x00.0x00), apVer = 1.22.134 (0x01.0x16.0x86), fpgaVer = null, scriptVer = null, macAddress = , devID = 0, devID1 = 0, devSN0 = 0, devSN1 = 0, serialNumber = null, appCommitID = null, scriptCommitID = null, PCB_ID = 0
1722 1764452234592 GEN4_TO_CONTROLLER_LOG:GEN4_CONNECT_INT_LOG Return End
1722 1764452234592 GEN4_CONNECT_DIAGNOSTICS:ENTERING: com.microchip.mplab.mdbcore.RI4Tool.ConnectionHandler.CheckForFWUpdates()
1722 1764452234592 GEN4_CONNECT_DIAGNOSTICS:Created FirmwareUpdateHandler com.microchip.mplab.mdbcore.AtmelIceScripting.OperationHandlers.AIceScriptingFirmwareUpdateHandler@694a2c3d

1722 1764452234596 GEN4_TO_CONTROLLER_LOG:GEN4_CONNECT_INT_LOG Pre:SetUpdateFirmwareInfo
1722 1764452234596 GEN4_TO_CONTROLLER_LOG:GEN4_CONNECT_INT_LOG Payload
1722 1764452234596 GEN4_TO_CONTROLLER_LOG:GEN4_CONNECT_INT_LOG UpdateFirmwareInfo: Values:
1722 1764452234596 GEN4_TO_CONTROLLER_LOG:GEN4_CONNECT_INT_LOG UpdateFirmwareInfo: license = , updateId = 255
1722 1764452234596 GEN4_TO_CONTROLLER_LOG:GEN4_CONNECT_INT_LOG Payload End
1722 1764452234596 GEN4_TO_CONTROLLER_LOG:GEN4_CONNECT_INT_LOG Post:SetUpdateFirmwareInfo
1722 1764452234596 GEN4_TO_CONTROLLER_LOG:GEN4_CONNECT_INT_LOG Return Value
1722 1764452234596 GEN4_TO_CONTROLLER_LOG:GEN4_CONNECT_INT_LOG none
1722 1764452234596 GEN4_TO_CONTROLLER_LOG:GEN4_CONNECT_INT_LOG Return End
1722 1764452234596 GEN4_CONNECT_DIAGNOSTICS:EXITING: com.microchip.mplab.mdbcore.RI4Tool.ConnectionHandler.CheckForFWUpdates()

1722 1764452234596 GEN4_TO_CONTROLLER_LOG:GEN4_CONNECT_INT_LOG Pre:SetPowerInfo
1722 1764452234596 GEN4_TO_CONTROLLER_LOG:GEN4_CONNECT_INT_LOG Payload
1722 1764452234596 GEN4_TO_CONTROLLER_LOG:GEN4_CONNECT_INT_LOG PowerInfo: Values:
1722 1764452234596 GEN4_TO_CONTROLLER_LOG:GEN4_CONNECT_INT_LOG PowerInfo: shotDownSystem = false, isToolPower = false, voltage = 5.000000, useVppFirst = false, useLowVoltageProgramming = true, useMaintainActivePower = false
1722 1764452234596 GEN4_TO_CONTROLLER_LOG:GEN4_CONNECT_INT_LOG Payload End
1722 1764452234597 NativeController::GetVoltageInfo entry
1722 1764452234597 pro JtagIce3 [0x01] <<< 02 00 01 00 02 
1722 1764452234608 pro JtagIce3 [0x01] >>> 84 01 88 13 00 
1722 1764452234608 pro JtagIce3 [0x01] <<< 02 00 01 20 02 
1722 1764452234624 pro JtagIce3 [0x01] >>> 84 01 00 00 11 
1722 1764452234624 NativeController::GetVoltageInfo TSUP exit with exception + The requested command is not supported. (17)
1722 1764452234624 pro JtagIce3 [0x01] <<< 02 00 01 02 02 
1722 1764452234640 pro JtagIce3 [0x01] >>> 84 01 00 00 11 
1722 1764452234640 NativeController::GetVoltageInfo VUSB exit with exception + The requested command is not supported. (17)
1722 1764452234640 NativeController::GetVoltageInfo exit
1722 1764452234640 GEN4_TO_CONTROLLER_LOG:GEN4_CONNECT_INT_LOG Post:SetPowerInfo
1722 1764452234640 GEN4_TO_CONTROLLER_LOG:GEN4_CONNECT_INT_LOG Return Value
1722 1764452234640 GEN4_TO_CONTROLLER_LOG:GEN4_CONNECT_INT_LOG none
1722 1764452234640 GEN4_TO_CONTROLLER_LOG:GEN4_CONNECT_INT_LOG Return End

1722 1764452234640 GEN4_TO_CONTROLLER_LOG:GEN4_CONNECT_INT_LOG Pre:GetVoltageInfo
1722 1764452234640 GEN4_TO_CONTROLLER_LOG:GEN4_CONNECT_INT_LOG Payload
1722 1764452234640 GEN4_TO_CONTROLLER_LOG:GEN4_CONNECT_INT_LOG null
1722 1764452234640 GEN4_TO_CONTROLLER_LOG:GEN4_CONNECT_INT_LOG Payload End
1722 1764452234640 NativeController::GetVoltageInfo entry
1722 1764452234640 pro JtagIce3 [0x01] <<< 02 00 01 00 02 
1722 1764452234656 pro JtagIce3 [0x01] >>> 84 01 88 13 00 
1722 1764452234656 pro JtagIce3 [0x01] <<< 02 00 01 20 02 
1722 1764452234672 pro JtagIce3 [0x01] >>> 84 01 00 00 11 
1722 1764452234672 NativeController::GetVoltageInfo TSUP exit with exception + The requested command is not supported. (17)
1722 1764452234672 pro JtagIce3 [0x01] <<< 02 00 01 02 02 
1722 1764452234688 pro JtagIce3 [0x01] >>> 84 01 00 00 11 
1722 1764452234688 NativeController::GetVoltageInfo VUSB exit with exception + The requested command is not supported. (17)
1722 1764452234688 NativeController::GetVoltageInfo exit
1722 1764452234688 GEN4_TO_CONTROLLER_LOG:GEN4_CONNECT_INT_LOG Post:GetVoltageInfo
1722 1764452234688 GEN4_TO_CONTROLLER_LOG:GEN4_CONNECT_INT_LOG Return Value
1722 1764452234688 GEN4_TO_CONTROLLER_LOG:GEN4_CONNECT_INT_LOG VoltagesInfo: Values:
1722 1764452234688 GEN4_TO_CONTROLLER_LOG:GEN4_CONNECT_INT_LOG VoltagesInfo: internalVdd = 0, internalVpp = 0, targetVdd = 0, targetVpp = -2147483648, vddSense = 5000, temp = 0, vddCurrentSense = 0, vddVoltageSense = -2147483648
1722 1764452234688 GEN4_TO_CONTROLLER_LOG:GEN4_CONNECT_INT_LOG Return End

1722 1764452234688 GEN4_TO_CONTROLLER_LOG:GEN4_CONNECT_INT_LOG Pre:SetLEDBrightness
1722 1764452234688 GEN4_TO_CONTROLLER_LOG:GEN4_CONNECT_INT_LOG Payload
1722 1764452234688 GEN4_TO_CONTROLLER_LOG:GEN4_CONNECT_INT_LOG 5
1722 1764452234688 GEN4_TO_CONTROLLER_LOG:GEN4_CONNECT_INT_LOG Payload End
1722 1764452234688 GEN4_TO_CONTROLLER_LOG:GEN4_CONNECT_INT_LOG Post:SetLEDBrightness
1722 1764452234688 GEN4_TO_CONTROLLER_LOG:GEN4_CONNECT_INT_LOG Return Value
1722 1764452234688 GEN4_TO_CONTROLLER_LOG:GEN4_CONNECT_INT_LOG none
1722 1764452234688 GEN4_TO_CONTROLLER_LOG:GEN4_CONNECT_INT_LOG Return End

1722 1764452234688 GEN4_TO_CONTROLLER_LOG:GEN4_CONNECT_INT_LOG Pre:SetToolInfo
1722 1764452234688 GEN4_TO_CONTROLLER_LOG:GEN4_CONNECT_INT_LOG Payload
1722 1764452234688 GEN4_TO_CONTROLLER_LOG:GEN4_CONNECT_INT_LOG ToolInfo: Values:
1722 1764452234688 GEN4_TO_CONTROLLER_LOG:GEN4_CONNECT_INT_LOG ToolInfo: speedLevel = 1, PGCResistance = 4700, PGDResistance = 4700, PGCPullDir = PullDown, PGDPullDir = PullDown, ICSPSelected = Wire2
1722 1764452234688 GEN4_TO_CONTROLLER_LOG:GEN4_CONNECT_INT_LOG Payload End
1722 1764452234688 GEN4_TO_CONTROLLER_LOG:GEN4_CONNECT_INT_LOG Post:SetToolInfo
1722 1764452234688 GEN4_TO_CONTROLLER_LOG:GEN4_CONNECT_INT_LOG Return Value
1722 1764452234688 GEN4_TO_CONTROLLER_LOG:GEN4_CONNECT_INT_LOG none
1722 1764452234688 GEN4_TO_CONTROLLER_LOG:GEN4_CONNECT_INT_LOG Return End

1722 1764452234688 GEN4_TO_CONTROLLER_LOG:GEN4_CONNECT_INT_LOG Pre:GetTargetIDInfo
1722 1764452234688 GEN4_TO_CONTROLLER_LOG:GEN4_CONNECT_INT_LOG Payload
1722 1764452234688 GEN4_TO_CONTROLLER_LOG:GEN4_CONNECT_INT_LOG null
1722 1764452234688 GEN4_TO_CONTROLLER_LOG:GEN4_CONNECT_INT_LOG Payload End
1722 1764452234688 NativeController::GetTargetIDInfo entry
1722 1764452234688 pro JtagIce3 [0x12] <<< 01 00 00 00 01 01 
1722 1764452234704 pro JtagIce3 [0x12] >>> 80 00 
1722 1764452234704 pro JtagIce3 [0x12] <<< 01 00 00 01 04 01 00 00 00 
1722 1764452234720 pro JtagIce3 [0x12] >>> 80 00 
1722 1764452234720 pro JtagIce3 [0x12] <<< 01 00 01 00 01 01 
1722 1764452234736 pro JtagIce3 [0x12] >>> 80 00 
1722 1764452234736 pro JtagIce3 [0x11] <<< 1D 7D 00 
1722 1764452234752 pro JtagIce3 [0x11] >>> 1D 00 
1722 1764452234752 pro JtagIce3 [0x11] <<< 10 C8 64 19 20 00 53 03 AC 53 00 00 
1722 1764452234870 pro JtagIce3 [0x11] >>> 10 C0
