upenn-embedded/final-project-website-submission-f25-t24-f25-team-1-team_name/UART1_test.X/queuelogs/debugtool.txt

530 1764432002774 pro JtagIce3 [0x11] >>> 06 00 
530 1764432002774 pro JtagIce3 [0x11] <<< 14 00 80 20 
530 1764432002877 pro JtagIce3 [0x11] >>> 14 00 81 F4 F7 01 E1 0F F1 1D 10 82 FF 92 EF 92 DF 92 CF 92 0E 94 DE 04 0F 90 0F 90 0F 90 0F 90 10 E0 07 C0 1F 33 28 F4 F7 01 E1 0F F1 1D 80 83 1F 5F CE 01 8F 5B 9F 4F 0E 94 57 05 81 11 DB CF 80 91 9D 01 88 23 A9 F3 10 92 9D 01 86 E3 91 E0 0E 94 0E 05 EE CF 0F 93 1F 93 CF 93 DF 93 DB 01 10 97 19 F4 8F EF 9F EF 3D C0 2D 91 3C 91 11 97 30 FF 25 C0 16 96 4D 91 5C 91 17 97 14 96 2D 91 3C 91 00 
530 1764432002877 pro JtagIce3 [0x11] <<< 06 00 00 03 00 
530 1764432002892 pro JtagIce3 [0x11] >>> 06 00 
530 1764432002892 pro JtagIce3 [0x11] <<< 14 00 80 20 
530 1764432002994 pro JtagIce3 [0x11] >>> 14 00 15 97 42 17 53 07 78 F4 12 96 ED 91 FC 91 13 97 80 83 12 96 2D 91 3C 91 13 97 2F 5F 3F 4F 13 96 3C 93 2E 93 12 97 16 96 2D 91 3C 91 17 97 2F 5F 3F 4F 17 96 3C 93 2E 93 16 97 13 C0 1C 96 ED 91 FC 91 1D 97 30 97 69 F2 EB 01 09 2F 18 2F 09 95 89 2B 39 F6 8E 81 9F 81 01 96 9F 83 8E 83 81 2F 90 2F DF 91 CF 91 1F 91 0F 91 08 95 A0 E0 B0 E0 EC E3 F3 E0 0C 94 95 04 6C 01 5B 01 7A 01 E9 01 00 
530 1764432002994 pro JtagIce3 [0x11] <<< 06 00 00 03 40 
530 1764432003010 pro JtagIce3 [0x11] >>> 06 00 
530 1764432003010 pro JtagIce3 [0x11] <<< 14 00 80 20 
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
530 1764432004324 GEN4_TO_CONTROLLER_LOG:GEN4_PROGRAM_INT_LOG_ATmega328PB Return Value
530 1764432004324 GEN4_TO_CONTROLLER_LOG:GEN4_PROGRAM_INT_LOG_ATmega328PB None
530 1764432004324 GEN4_TO_CONTROLLER_LOG:GEN4_PROGRAM_INT_LOG_ATmega328PB Return End

530 1764432004326 GEN4_TO_CONTROLLER_LOG:GEN4_PROGRAM_INT_LOG_ATmega328PB Pre:SendOperation
530 1764432004326 GEN4_TO_CONTROLLER_LOG:GEN4_PROGRAM_INT_LOG_ATmega328PB Payload
530 1764432004326 GEN4_TO_CONTROLLER_LOG:GEN4_PROGRAM_INT_LOG_ATmega328PB OperationInfo: Values:
530 1764432004326 GEN4_TO_CONTROLLER_LOG:GEN4_PROGRAM_INT_LOG_ATmega328PB OperationInfo: Type = releasefromreset, Mask = 00000000, Erase = false, Production Mode = true
530 1764432004326 GEN4_TO_CONTROLLER_LOG:GEN4_PROGRAM_INT_LOG_ATmega328PB Payload End
530 1764432004326 pro JtagIce3 [0x01] <<< 11 00 00 
530 1764432004340 pro JtagIce3 [0x01] >>> 80 00 
530 1764432004340 GEN4_TO_CONTROLLER_LOG:GEN4_PROGRAM_INT_LOG_ATmega328PB Post:SendOperation
530 1764432004340 GEN4_TO_CONTROLLER_LOG:GEN4_PROGRAM_INT_LOG_ATmega328PB Return Value
530 1764432004340 GEN4_TO_CONTROLLER_LOG:GEN4_PROGRAM_INT_LOG_ATmega328PB None
530 1764432004340 GEN4_TO_CONTROLLER_LOG:GEN4_PROGRAM_INT_LOG_ATmega328PB Return End
530 1764432004340 GEN4_CONNECT_DIAGNOSTICS:MPLABCommTool is null

530 1764432004340 GEN4_TO_CONTROLLER_LOG:GEN4_CONNECT_INT_LOG Pre:GetFirmwareInfo
530 1764432004340 GEN4_TO_CONTROLLER_LOG:GEN4_CONNECT_INT_LOG Payload
530 1764432004340 GEN4_TO_CONTROLLER_LOG:GEN4_CONNECT_INT_LOG null
530 1764432004340 GEN4_TO_CONTROLLER_LOG:GEN4_CONNECT_INT_LOG Payload End
530 1764432004340 NativeController::GetFirmwareInfo entry
530 1764432004340 pro JtagIce3 [0x01] <<< 02 00 00 00 01 
530 1764432004356 pro JtagIce3 [0x01] >>> 84 01 00 00 
530 1764432004356 NativeController::getFirmwareVersion entry
530 1764432004356 pro JtagIce3 [0x01] <<< 02 00 00 01 01 
530 1764432004372 pro JtagIce3 [0x01] >>> 84 01 01 00 
530 1764432004372 pro JtagIce3 [0x01] <<< 02 00 00 02 01 
530 1764432004388 pro JtagIce3 [0x01] >>> 84 01 16 00 
530 1764432004388 pro JtagIce3 [0x01] <<< 02 00 00 03 02 
530 1764432004405 pro JtagIce3 [0x01] >>> 84 01 86 00 00 
530 1764432004405 NativeController::getFirmwareVersion exit
530 1764432004405 pro JtagIce3 [0x01] <<< 02 00 00 09 01 
530 1764432004420 pro JtagIce3 [0x01] >>> 84 01 FF 00 
530 1764432004420 NativeController::tryGetFPGAVersion entry
530 1764432004420 pro JtagIce3 [0x01] <<< 02 00 00 10 01 
530 1764432004436 pro JtagIce3 [0x01] >>> 84 01 00 11 
530 1764432004436 pro JtagIce3 [0x01] <<< 02 00 00 11 01 
530 1764432004452 pro JtagIce3 [0x01] >>> 84 01 00 11 
530 1764432004452 pro JtagIce3 [0x01] <<< 02 00 00 12 01 
530 1764432004468 pro JtagIce3 [0x01] >>> 84 01 00 11 
530 1764432004468 NativeController::tryGetFPGAVersion exit
530 1764432004468 NativeController::tryGetFPGAVersion exit with exception No value present
530 1764432004468 pro JtagIce3 [0x01] <<< 02 00 00 06 01 
530 1764432004483 pro JtagIce3 [0x01] >>> 84 01 01 00 
530 1764432004483 pro JtagIce3 [0x01] <<< 02 00 00 07 01 
530 1764432004500 pro JtagIce3 [0x01] >>> 84 01 00 00 
530 1764432004500 pro JtagIce3 [0x01] <<< 02 00 00 0A 01 
530 1764432004516 pro JtagIce3 [0x01] >>> 84 01 00 11 
530 1764432004516 NativeController::GetFirmwareInfo exit
530 1764432004516 GEN4_TO_CONTROLLER_LOG:GEN4_CONNECT_INT_LOG Post:GetFirmwareInfo
530 1764432004516 GEN4_TO_CONTROLLER_LOG:GEN4_CONNECT_INT_LOG Return Value
530 1764432004516 GEN4_TO_CONTROLLER_LOG:GEN4_CONNECT_INT_LOG FirmwareInfo: Values:
530 1764432004516 GEN4_TO_CONTROLLER_LOG:GEN4_CONNECT_INT_LOG FirmwareInfo: boot = false, bootVer = 1.0.0 (0x01.0x00.0x00), apVer = 1.22.134 (0x01.0x16.0x86), fpgaVer = null, scriptVer = null, macAddress = , devID = 0, devID1 = 0, devSN0 = 0, devSN1 = 0, serialNumber = null, appCommitID = null, scriptCommitID = null, PCB_ID = 0
530 1764432004516 GEN4_TO_CONTROLLER_LOG:GEN4_CONNECT_INT_LOG Return End

530 1764432004516 GEN4_TO_CONTROLLER_LOG:GEN4_CONNECT_INT_LOG Pre:SetPowerInfo
530 1764432004516 GEN4_TO_CONTROLLER_LOG:GEN4_CONNECT_INT_LOG Payload
530 1764432004516 GEN4_TO_CONTROLLER_LOG:GEN4_CONNECT_INT_LOG PowerInfo: Values:
530 1764432004516 GEN4_TO_CONTROLLER_LOG:GEN4_CONNECT_INT_LOG PowerInfo: shotDownSystem = true, isToolPower = false, voltage = 0.000000, useVppFirst = false, useLowVoltageProgramming = true, useMaintainActivePower = false
530 1764432004516 GEN4_TO_CONTROLLER_LOG:GEN4_CONNECT_INT_LOG Payload End
530 1764432004516 NativeController::GetVoltageInfo entry
530 1764432004516 pro JtagIce3 [0x01] <<< 02 00 01 00 02 
530 1764432004532 pro JtagIce3 [0x01] >>> 84 01 88 13 00 
530 1764432004532 pro JtagIce3 [0x01] <<< 02 00 01 20 02 
530 1764432004548 pro JtagIce3 [0x01] >>> 84 01 00 00 11 
530 1764432004548 NativeController::GetVoltageInfo TSUP exit with exception + The requested command is not supported. (17)
530 1764432004548 pro JtagIce3 [0x01] <<< 02 00 01 02 02 
530 1764432004564 pro JtagIce3 [0x01] >>> 84 01 00 00 11 
530 1764432004564 NativeController::GetVoltageInfo VUSB exit with exception + The requested command is not supported. (17)
530 1764432004564 NativeController::GetVoltageInfo exit
530 1764432004564 GEN4_TO_CONTROLLER_LOG:GEN4_CONNECT_INT_LOG Post:SetPowerInfo
530 1764432004564 GEN4_TO_CONTROLLER_LOG:GEN4_CONNECT_INT_LOG Return Value
530 1764432004564 GEN4_TO_CONTROLLER_LOG:GEN4_CONNECT_INT_LOG none
530 1764432004564 GEN4_TO_CONTROLLER_LOG:GEN4_CONNECT_INT_LOG Return End

530 1764432004564 GEN4_TO_CONTROLLER_LOG:GEN4_CONNECT_INT_LOG Pre:Disconnect
530 1764432004564 GEN4_TO_CONTROLLER_LOG:GEN4_CONNECT_INT_LOG Payload
530 1764432004564 GEN4_TO_CONTROLLER_LOG:GEN4_CONNECT_INT_LOG Payload End
530 1764432004564 NativeController::Disconnect entry
530 1764432004564 pro JtagIce3 [0x01] <<< 11 00 00 
530 1764432004580 pro JtagIce3 [0x01] >>> 80 00 
530 1764432004580 NativeController::Disconnect exit
530 1764432004580 GEN4_TO_CONTROLLER_LOG:GEN4_CONNECT_INT_LOG Post:Disconnect
530 1764432004580 GEN4_TO_CONTROLLER_LOG:GEN4_CONNECT_INT_LOG Return Value
530 1764432004580 GEN4_TO_CONTROLLER_LOG:GEN4_CONNECT_INT_LOG none
530 1764432004580 GEN4_TO_CONTROLLER_LOG:GEN4_CONNECT_INT_LOG Return End
530 1764432004580 GEN4_CONNECT_DIAGNOSTICS:Removing plug and play observer com.microchip.mplab.mdbcore.RI4Tool.RI4ToolBase$RI4PlugNPlayObserver@3f2ff653
530 1764432004580 GEN4_CONNECT_DIAGNOSTICS:Begin PlugNPlayObservers list dump:
530 1764432004580 GEN4_CONNECT_DIAGNOSTICS:End PlugNPlayObservers list dump:
530 1764432004681 GEN4_CONNECT_DIAGNOSTICS:Calling RIDbgToolCom.Disconnect
530 1764432004681 GEN4_CONNECT_DIAGNOSTICS:Calling MPLABCommTool.Detach to remove tool from plug and play list
530 1764432004681 GEN4_CONNECT_DIAGNOSTICS:Calling RIDbgToolCom.DisconnectFromMPlabComm
530 1764432004681 GEN4_CONNECT_DIAGNOSTICS:Calling MPLABCommTool.Disconnect
549 1764432048759 GEN4_CONNECT_DIAGNOSTICS:MPLABCommTool is NOT null
549 1764432048759 GEN4_CONNECT_DIAGNOSTICS:AttachedToolPID = 2145, AttachedToolVID = 3eb
549 1764432048759 GEN4_CONNECT_DIAGNOSTICS:transport type = USB
549 1764432048759 GEN4_CONNECT_DIAGNOSTICS:AttachedToolPID = 2145, AttachedToolVID = 3eb
549 1764432048761 com.microchip.mplab.mdbcore.RealICETool.RIDbgToolCom
549 1764432048761 GEN4_CONNECT_DIAGNOSTICS:Before MPLABCommTool.Connect()
549 1764432048761 GEN4_CONNECT_DIAGNOSTICS:After MPLABCommTool.Connect()
549 1764432048761 GEN4_CONNECT_DIAGNOSTICS:MPLABCommTool.Connect() returned MPLABCOMM_NO_ERROR
549 1764432048761 GEN4_CONNECT_DIAGNOSTICS:Attaching to MPLABCommTool plugnplay
549 1764432048761 GEN4_CONNECT_DIAGNOSTICS:Adding new plug and play observer com.microchip.mplab.mdbcore.RI4Tool.RI4ToolBase$RI4PlugNPlayObserver@63bbace1
549 1764432048761 GEN4_CONNECT_DIAGNOSTICS:Begin PlugNPlayObservers list dump:
549 1764432048761 GEN4_CONNECT_DIAGNOSTICS:com.microchip.mplab.mdbcore.RI4Tool.RI4ToolBase$RI4PlugNPlayObserver@63bbace1
549 1764432048761 GEN4_CONNECT_DIAGNOSTICS:End PlugNPlayObservers list dump:
549 1764432048762 GEN4_CONNECT_DIAGNOSTICS:Registering for alternate PNP notifications. CommPnPCriteria.cPIDList = [2ff4], CommPnPCriteria.cSerialNumber = atml2523052700011486

549 1764432048782 GEN4_TO_CONTROLLER_LOG:GEN4_INIT_INT_LOG_ATmega328PB Pre:init
549 1764432048782 GEN4_TO_CONTROLLER_LOG:GEN4_INIT_INT_LOG_ATmega328PB Payload
549 1764432048782 GEN4_TO_CONTROLLER_LOG:GEN4_INIT_INT_LOG_ATmega328PB DeviceInfo: Values:
549 1764432048782 GEN4_TO_CONTROLLER_LOG:GEN4_INIT_INT_LOG_ATmega328PB DeviceInfo: pcAddress = 7fffffffffffffff, Vpp = 5.00, useRowEraseIfVoltageIsLow = false, voltageBelowWhichUseRowErase = 0.00, deviceName = ATmega328PB, programmerType = 
549 1764432048782 GEN4_TO_CONTROLLER_LOG:GEN4_INIT_INT_LOG_ATmega328PB DeviceInfo: MemInfo values:
549 1764432048782 GEN4_TO_CONTROLLER_LOG:GEN4_INIT_INT_LOG_ATmega328PB DeviceInfo: mask = ffff, exists = true, startAddr = 00000000, endAddr = 00007fff, rowSize = 0080, rowEraseSize = 0080, addrInc = 0001, widthProgram = 0001
549 1764432048782 GEN4_TO_CONTROLLER_LOG:GEN4_INIT_INT_LOG_ATmega328PB DeviceInfo: mask = 00ff, exists = true, startAddr = 00820000, endAddr = 00820002, rowSize = 0001, rowEraseSize = 0000, addrInc = 0001, widthProgram = 0001
549 1764432048782 GEN4_TO_CONTROLLER_LOG:GEN4_INIT_INT_LOG_ATmega328PB DeviceInfo: mask = 0000, exists = false, startAddr = 00000000, endAddr = 00000000, rowSize = 0000, rowEraseSize = 0000, addrInc = 0000, widthProgram = 0000
549 1764432048782 GEN4_TO_CONTROLLER_LOG:GEN4_INIT_INT_LOG_ATmega328PB DeviceInfo: mask = 0000, exists = false, startAddr = 00000000, endAddr = 00000000, rowSize = 0000, rowEraseSize = 0000, addrInc = 0000, widthProgram = 0000
549 1764432048782 GEN4_TO_CONTROLLER_LOG:GEN4_INIT_INT_LOG_ATmega328PB DeviceInfo: mask = 0000, exists = false, startAddr = 00000000, endAddr = 00000000, rowSize = 0000, rowEraseSize = 0000, addrInc = 0000, widthProgram = 0000
549 1764432048782 GEN4_TO_CONTROLLER_LOG:GEN4_INIT_INT_LOG_ATmega328PB DeviceInfo: mask = 0000, exists = false, startAddr = 00000000, endAddr = 00000000, rowSize = 0000, rowEraseSize = 0080, addrInc = 0000, widthProgram = 0000
549 1764432048782 GEN4_TO_CONTROLLER_LOG:GEN4_INIT_INT_LOG_ATmega328PB DeviceInfo: mask = 0000, exists = false, startAddr = 00000000, endAddr = 00000000, rowSize = 0000, rowEraseSize = 0000, addrInc = 0001, widthProgram = 0001
549 1764432048782 GEN4_TO_CONTROLLER_LOG:GEN4_INIT_INT_LOG_ATmega328PB DeviceInfo: mask = 0000, exists = false, startAddr = 00000000, endAddr = 00000000, rowSize = 0000, rowEraseSize = 0000, addrInc = 0000, widthProgram = 0000
549 1764432048782 GEN4_TO_CONTROLLER_LOG:GEN4_INIT_INT_LOG_ATmega328PB DeviceInfo: mask = 00ff, exists = true, startAddr = 00000000, endAddr = 000003ff, rowSize = 0004, rowEraseSize = 0000, addrInc = 0001, widthProgram = 0001
549 1764432048782 GEN4_TO_CONTROLLER_LOG:GEN4_INIT_INT_LOG_ATmega328PB DeviceInfo: mask = 0000, exists = false, startAddr = 00000000, endAddr = 00000000, rowSize = 0000, rowEraseSize = 0000, addrInc = 0000, widthProgram = 0000
549 1764432048782 GEN4_TO_CONTROLLER_LOG:GEN4_INIT_INT_LOG_ATmega328PB DeviceInfo: mask = 0000, exists = false, startAddr = 00000000, endAddr = 00000000, rowSize = 0000, rowEraseSize = 0000, addrInc = 0000, widthProgram = 0000
549 1764432048782 GEN4_TO_CONTROLLER_LOG:GEN4_INIT_INT_LOG_ATmega328PB DeviceInfo: mask = 0000, exists = false, startAddr = 00000000, endAddr = 00000000, rowSize = 0000, rowEraseSize = 0000, addrInc = 0001, widthProgram = 0001
549 1764432048782 GEN4_TO_CONTROLLER_LOG:GEN4_INIT_INT_LOG_ATmega328PB DeviceInfo: mask = 0000, exists = false, startAddr = 00000000, endAddr = 00000000, rowSize = 0000, rowEraseSize = 0000, addrInc = 0000, widthProgram = 0000
549 1764432048782 GEN4_TO_CONTROLLER_LOG:GEN4_INIT_INT_LOG_ATmega328PB DeviceInfo: mask = 0000, exists = false, startAddr = 00000000, endAddr = 00000000, rowSize = 0000, rowEraseSize = 0000, addrInc = 0000, widthProgram = 0000
549 1764432048782 GEN4_TO_CONTROLLER_LOG:GEN4_INIT_INT_LOG_ATmega328PB DeviceInfo: mask = 0000, exists = false, startAddr = 00000000, endAddr = 00000000, rowSize = 0000, rowEraseSize = 0000, addrInc = 0000, widthProgram = 0000
549 1764432048782 GEN4_TO_CONTROLLER_LOG:GEN4_INIT_INT_LOG_ATmega328PB DeviceInfo: mask = 0000, exists = false, startAddr = 00000000, endAddr = 00000000, rowSize = 0000, rowEraseSize = 0000, addrInc = 0000, widthProgram = 0000
549 1764432048782 GEN4_TO_CONTROLLER_LOG:GEN4_INIT_INT_LOG_ATmega328PB DeviceInfo: mask = 7fffffff, exists = true, startAddr = 00840000, endAddr = 00840002, rowSize = 0001, rowEraseSize = 0000, addrInc = 0001, widthProgram = 0001
549 1764432048782 GEN4_TO_CONTROLLER_LOG:GEN4_INIT_INT_LOG_ATmega328PB DeviceInfo: mask = 0000, exists = false, startAddr = 00000000, endAddr = 00000000, rowSize = 0000, rowEraseSize = 0000, addrInc = 0000, widthProgram = 0000
549 1764432048782 GEN4_TO_CONTROLLER_LOG:GEN4_INIT_INT_LOG_ATmega328PB DeviceInfo: mask = 0000, exists = false, startAddr = 00000000, endAddr = 00000000, rowSize = 0000, rowEraseSize = 0000, addrInc = 0000, widthProgram = 0000
549 1764432048782 GEN4_TO_CONTROLLER_LOG:GEN4_INIT_INT_LOG_ATmega328PB DeviceInfo: mask = 0000, exists = false, startAddr = 00000000, endAddr = 00000000, rowSize = 0000, rowEraseSize = 0000, addrInc = 0000, widthProgram = 0000
549 1764432048782 GEN4_TO_CONTROLLER_LOG:GEN4_INIT_INT_LOG_ATmega328PB DeviceInfo: mask = 0000, exists = false, startAddr = 00000000, endAddr = 00000000, rowSize = 0000, rowEraseSize = 0000, addrInc = 0000, widthProgram = 0000
549 1764432048782 GEN4_TO_CONTROLLER_LOG:GEN4_INIT_INT_LOG_ATmega328PB DeviceInfo: mask = 0000, exists = false, startAddr = 00000000, endAddr = 00000000, rowSize = 0000, rowEraseSize = 0000, addrInc = 0000, widthProgram = 0000
549 1764432048782 GEN4_TO_CONTROLLER_LOG:GEN4_INIT_INT_LOG_ATmega328PB DeviceInfo: mask = 0000, exists = false, startAddr = 00000000, endAddr = 00000000, rowSize = 0000, rowEraseSize = 0000, addrInc = 0000, widthProgram = 0000
549 1764432048782 GEN4_TO_CONTROLLER_LOG:GEN4_INIT_INT_LOG_ATmega328PB DeviceInfo: CfgRequiredBitsMask Values:
549 1764432048782 GEN4_TO_CONTROLLER_LOG:GEN4_INIT_INT_LOG_ATmega328PB Address = 00820000, Mask = 000000ff
549 1764432048782 GEN4_TO_CONTROLLER_LOG:GEN4_INIT_INT_LOG_ATmega328PB Address = 00820001, Mask = 000000ff
549 1764432048782 GEN4_TO_CONTROLLER_LOG:GEN4_INIT_INT_LOG_ATmega328PB Address = 00820002, Mask = 0000000f
549 1764432048782 GEN4_TO_CONTROLLER_LOG:GEN4_INIT_INT_LOG_ATmega328PB Address = 00830000, Mask = 0000003f
549 1764432048782 GEN4_TO_CONTROLLER_LOG:GEN4_INIT_INT_LOG_ATmega328PB BasicInfo: Values:
549 1764432048782 GEN4_TO_CONTROLLER_LOG:GEN4_INIT_INT_LOG_ATmega328PB Payload End
549 1764432048782 GEN4_TO_CONTROLLER_LOG:GEN4_INIT_INT_LOG_ATmega328PB Post:init
549 1764432048782 GEN4_TO_CONTROLLER_LOG:GEN4_INIT_INT_LOG_ATmega328PB Return Value
549 1764432048782 GEN4_TO_CONTROLLER_LOG:GEN4_INIT_INT_LOG_ATmega328PB none
549 1764432048782 GEN4_TO_CONTROLLER_LOG:GEN4_INIT_INT_LOG_ATmega328PB Return End

549 1764432048782 GEN4_TO_CONTROLLER_LOG:GEN4_INIT_INT_LOG_ATmega328PB Pre:GetInterfaceProvider
549 1764432048782 GEN4_TO_CONTROLLER_LOG:GEN4_INIT_INT_LOG_ATmega328PB Payload
549 1764432048782 GEN4_TO_CONTROLLER_LOG:GEN4_INIT_INT_LOG_ATmega328PB RI4DebugInterface
549 1764432048782 GEN4_TO_CONTROLLER_LOG:GEN4_INIT_INT_LOG_ATmega328PB Payload End
549 1764432048782 GEN4_TO_CONTROLLER_LOG:GEN4_INIT_INT_LOG_ATmega328PB Post:GetInterfaceProvider
549 1764432048782 GEN4_TO_CONTROLLER_LOG:GEN4_INIT_INT_LOG_ATmega328PB Return Value
549 1764432048782 GEN4_TO_CONTROLLER_LOG:GEN4_INIT_INT_LOG_ATmega328PB com.microchip.mplab.libs.atmelice.implementations.DebugInterface@59174084
549 1764432048782 GEN4_TO_CONTROLLER_LOG:GEN4_INIT_INT_LOG_ATmega328PB Return End

549 1764432048783 GEN4_TO_CONTROLLER_LOG:GEN4_INIT_INT_LOG_ATmega328PB Pre:GetInterfaceProvider
549 1764432048783 GEN4_TO_CONTROLLER_LOG:GEN4_INIT_INT_LOG_ATmega328PB Payload
549 1764432048783 GEN4_TO_CONTROLLER_LOG:GEN4_INIT_INT_LOG_ATmega328PB RI4ProgramInterface
549 1764432048783 GEN4_TO_CONTROLLER_LOG:GEN4_INIT_INT_LOG_ATmega328PB Payload End
549 1764432048783 GEN4_TO_CONTROLLER_LOG:GEN4_INIT_INT_LOG_ATmega328PB Post:GetInterfaceProvider
549 1764432048783 GEN4_TO_CONTROLLER_LOG:GEN4_INIT_INT_LOG_ATmega328PB Return Value
549 1764432048783 GEN4_TO_CONTROLLER_LOG:GEN4_INIT_INT_LOG_ATmega328PB com.microchip.mplab.libs.atmelice.implementations.ProgramInterface@67f533e3
549 1764432048783 GEN4_TO_CONTROLLER_LOG:GEN4_INIT_INT_LOG_ATmega328PB Return End

549 1764432048783 GEN4_TO_CONTROLLER_LOG:GEN4_INIT_INT_LOG_ATmega328PB Pre:GetInterfaceProvider
549 1764432048783 GEN4_TO_CONTROLLER_LOG:GEN4_INIT_INT_LOG_ATmega328PB Payload
549 1764432048783 GEN4_TO_CONTROLLER_LOG:GEN4_INIT_INT_LOG_ATmega328PB RI4ConnectInterface
549 1764432048783 GEN4_TO_CONTROLLER_LOG:GEN4_INIT_INT_LOG_ATmega328PB Payload End
549 1764432048783 GEN4_TO_CONTROLLER_LOG:GEN4_INIT_INT_LOG_ATmega328PB Post:GetInterfaceProvider
549 1764432048783 GEN4_TO_CONTROLLER_LOG:GEN4_INIT_INT_LOG_ATmega328PB Return Value
549 1764432048783 GEN4_TO_CONTROLLER_LOG:GEN4_INIT_INT_LOG_ATmega328PB com.microchip.mplab.libs.atmelice.implementations.ConnectInterface@281d9aa3
549 1764432048783 GEN4_TO_CONTROLLER_LOG:GEN4_INIT_INT_LOG_ATmega328PB Return End

549 1764432048783 GEN4_TO_CONTROLLER_LOG:GEN4_INIT_INT_LOG_ATmega328PB Pre:GetInterfaceProvider
549 1764432048783 GEN4_TO_CONTROLLER_LOG:GEN4_INIT_INT_LOG_ATmega328PB Payload
549 1764432048783 GEN4_TO_CONTROLLER_LOG:GEN4_INIT_INT_LOG_ATmega328PB RI4ControllerDiagnosticsInterface
549 1764432048783 GEN4_TO_CONTROLLER_LOG:GEN4_INIT_INT_LOG_ATmega328PB Payload End
549 1764432048783 GEN4_TO_CONTROLLER_LOG:GEN4_INIT_INT_LOG_ATmega328PB Post:GetInterfaceProvider
549 1764432048783 GEN4_TO_CONTROLLER_LOG:GEN4_INIT_INT_LOG_ATmega328PB Return Value
549 1764432048783 GEN4_TO_CONTROLLER_LOG:GEN4_INIT_INT_LOG_ATmega328PB com.microchip.mplab.libs.atmelice.implementations.UnimplementedDiagnostics@710a95c5
549 1764432048783 GEN4_TO_CONTROLLER_LOG:GEN4_INIT_INT_LOG_ATmega328PB Return End

549 1764432048783 GEN4_TO_CONTROLLER_LOG:GEN4_INIT_INT_LOG_ATmega328PB Pre:GetInterfaceProvider
549 1764432048783 GEN4_TO_CONTROLLER_LOG:GEN4_INIT_INT_LOG_ATmega328PB Payload
549 1764432048783 GEN4_TO_CONTROLLER_LOG:GEN4_INIT_INT_LOG_ATmega328PB ProgrammerToGo
549 1764432048783 GEN4_TO_CONTROLLER_LOG:GEN4_INIT_INT_LOG_ATmega328PB Payload End
549 1764432048783 GEN4_TO_CONTROLLER_LOG:GEN4_INIT_INT_LOG_ATmega328PB Post:GetInterfaceProvider
549 1764432048783 GEN4_TO_CONTROLLER_LOG:GEN4_INIT_INT_LOG_ATmega328PB Return Value
549 1764432048783 GEN4_TO_CONTROLLER_LOG:GEN4_INIT_INT_LOG_ATmega328PB null
549 1764432048783 GEN4_TO_CONTROLLER_LOG:GEN4_INIT_INT_LOG_ATmega328PB Return End

549 1764432048783 GEN4_TO_CONTROLLER_LOG:GEN4_INIT_INT_LOG_ATmega328PB Pre:GetInterfaceProvider
549 1764432048783 GEN4_TO_CONTROLLER_LOG:GEN4_INIT_INT_LOG_ATmega328PB Payload
549 1764432048783 GEN4_TO_CONTROLLER_LOG:GEN4_INIT_INT_LOG_ATmega328PB Status
549 1764432048783 GEN4_TO_CONTROLLER_LOG:GEN4_INIT_INT_LOG_ATmega328PB Payload End
549 1764432048783 GEN4_TO_CONTROLLER_LOG:GEN4_INIT_INT_LOG_ATmega328PB Post:GetInterfaceProvider
549 1764432048783 GEN4_TO_CONTROLLER_LOG:GEN4_INIT_INT_LOG_ATmega328PB Return Value
549 1764432048783 GEN4_TO_CONTROLLER_LOG:GEN4_INIT_INT_LOG_ATmega328PB null
549 1764432048783 GEN4_TO_CONTROLLER_LOG:GEN4_INIT_INT_LOG_ATmega328PB Return End

549 1764432048788 GEN4_TO_CONTROLLER_LOG:GEN4_CONNECT_INT_LOG Pre:EstablishCommunincations
549 1764432048788 GEN4_TO_CONTROLLER_LOG:GEN4_CONNECT_INT_LOG Payload
549 1764432048788 GEN4_TO_CONTROLLER_LOG:GEN4_CONNECT_INT_LOG com.microchip.mplab.mdbcore.AtmelIceScripting.AIceScriptingCom@12faf800
549 1764432048788 GEN4_TO_CONTROLLER_LOG:GEN4_CONNECT_INT_LOG Payload End
549 1764432048788 NativeController::EstablishCommunincations entry
549 1764432048788 pro JtagIce3 [0x00] <<< 00 00 00 
549 1764432048813 pro JtagIce3 [0x00] >>> 81 00 00 01 12 20 11 
549 1764432048813 pro JtagIce3 [0x01] <<< 10 00 
549 1764432048828 pro JtagIce3 [0x01] >>> 80 00 
549 1764432048828 pro JtagIce3 [0x00] <<< 00 00 03 
549 1764432048844 pro JtagIce3 [0x00] >>> 81 00 01 05 
549 1764432048844 NativeController::EstablishCommunincations exit
549 1764432048844 GEN4_TO_CONTROLLER_LOG:GEN4_CONNECT_INT_LOG Post:EstablishCommunincations
549 1764432048844 GEN4_TO_CONTROLLER_LOG:GEN4_CONNECT_INT_LOG Return Value
549 1764432048844 GEN4_TO_CONTROLLER_LOG:GEN4_CONNECT_INT_LOG true
549 1764432048844 GEN4_TO_CONTROLLER_LOG:GEN4_CONNECT_INT_LOG Return End

549 1764432048844 GEN4_TO_CONTROLLER_LOG:GEN4_CONNECT_INT_LOG Pre:GetFirmwareInfo
549 1764432048844 GEN4_TO_CONTROLLER_LOG:GEN4_CONNECT_INT_LOG Payload
549 1764432048844 GEN4_TO_CONTROLLER_LOG:GEN4_CONNECT_INT_LOG null
549 1764432048844 GEN4_TO_CONTROLLER_LOG:GEN4_CONNECT_INT_LOG Payload End
549 1764432048844 NativeController::GetFirmwareInfo entry
549 1764432048844 pro JtagIce3 [0x01] <<< 02 00 00 00 01 
549 1764432048860 pro JtagIce3 [0x01] >>> 84 01 00 00 
549 1764432048860 NativeController::getFirmwareVersion entry
549 1764432048860 pro JtagIce3 [0x01] <<< 02 00 00 01 01 
549 1764432048876 pro JtagIce3 [0x01] >>> 84 01 01 00 
549 1764432048876 pro JtagIce3 [0x01] <<< 02 00 00 02 01 
549 1764432048892 pro JtagIce3 [0x01] >>> 84 01 16 00 
549 1764432048892 pro JtagIce3 [0x01] <<< 02 00 00 03 02 
549 1764432048908 pro JtagIce3 [0x01] >>> 84 01 86 00 00 
549 1764432048908 NativeController::getFirmwareVersion exit
549 1764432048908 pro JtagIce3 [0x01] <<< 02 00 00 09 01 
549 1764432048924 pro JtagIce3 [0x01] >>> 84 01 FF 00 
549 1764432048924 NativeController::tryGetFPGAVersion entry
549 1764432048924 pro JtagIce3 [0x01] <<< 02 00 00 10 01 
549 1764432048940 pro JtagIce3 [0x01] >>> 84 01 00 11 
549 1764432048940 pro JtagIce3 [0x01] <<< 02 00 00 11 01 
549 1764432048956 pro JtagIce3 [0x01] >>> 84 01 00 11 
549 1764432048956 pro JtagIce3 [0x01] <<< 02 00 00 12 01 
549 1764432048972 pro JtagIce3 [0x01] >>> 84 01 00 11 
549 1764432048972 NativeController::tryGetFPGAVersion exit
549 1764432048972 NativeController::tryGetFPGAVersion exit with exception No value present
549 1764432048972 pro JtagIce3 [0x01] <<< 02 00 00 06 01 
549 1764432048988 pro JtagIce3 [0x01] >>> 84 01 01 00 
549 1764432048988 pro JtagIce3 [0x01] <<< 02 00 00 07 01 
549 1764432049004 pro JtagIce3 [0x01] >>> 84 01 00 00 
549 1764432049004 pro JtagIce3 [0x01] <<< 02 00 00 0A 01 
549 1764432049020 pro JtagIce3 [0x01] >>> 84 01 00 11 
549 1764432049020 NativeController::GetFirmwareInfo exit
549 1764432049020 GEN4_TO_CONTROLLER_LOG:GEN4_CONNECT_INT_LOG Post:GetFirmwareInfo
549 1764432049020 GEN4_TO_CONTROLLER_LOG:GEN4_CONNECT_INT_LOG Return Value
549 1764432049020 GEN4_TO_CONTROLLER_LOG:GEN4_CONNECT_INT_LOG FirmwareInfo: Values:
549 1764432049020 GEN4_TO_CONTROLLER_LOG:GEN4_CONNECT_INT_LOG FirmwareInfo: boot = false, bootVer = 1.0.0 (0x01.0x00.0x00), apVer = 1.22.134 (0x01.0x16.0x86), fpgaVer = null, scriptVer = null, macAddress = , devID = 0, devID1 = 0, devSN0 = 0, devSN1 = 0, serialNumber = null, appCommitID = null, scriptCommitID = null, PCB_ID = 0
549 1764432049020 GEN4_TO_CONTROLLER_LOG:GEN4_CONNECT_INT_LOG Return End
549 1764432049020 GEN4_CONNECT_DIAGNOSTICS:ENTERING: com.microchip.mplab.mdbcore.RI4Tool.ConnectionHandler.CheckForFWUpdates()
549 1764432049020 GEN4_CONNECT_DIAGNOSTICS:Created FirmwareUpdateHandler com.microchip.mplab.mdbcore.AtmelIceScripting.OperationHandlers.AIceScriptingFirmwareUpdateHandler@5c5ebb97

549 1764432049025 GEN4_TO_CONTROLLER_LOG:GEN4_CONNECT_INT_LOG Pre:SetUpdateFirmwareInfo
549 1764432049025 GEN4_TO_CONTROLLER_LOG:GEN4_CONNECT_INT_LOG Payload
549 1764432049025 GEN4_TO_CONTROLLER_LOG:GEN4_CONNECT_INT_LOG UpdateFirmwareInfo: Values:
549 1764432049025 GEN4_TO_CONTROLLER_LOG:GEN4_CONNECT_INT_LOG UpdateFirmwareInfo: license = , updateId = 255
549 1764432049025 GEN4_TO_CONTROLLER_LOG:GEN4_CONNECT_INT_LOG Payload End
549 1764432049025 GEN4_TO_CONTROLLER_LOG:GEN4_CONNECT_INT_LOG Post:SetUpdateFirmwareInfo
549 1764432049025 GEN4_TO_CONTROLLER_LOG:GEN4_CONNECT_INT_LOG Return Value
549 1764432049025 GEN4_TO_CONTROLLER_LOG:GEN4_CONNECT_INT_LOG none
549 1764432049025 GEN4_TO_CONTROLLER_LOG:GEN4_CONNECT_INT_LOG Return End
549 1764432049025 GEN4_CONNECT_DIAGNOSTICS:EXITING: com.microchip.mplab.mdbcore.RI4Tool.ConnectionHandler.CheckForFWUpdates()

549 1764432049025 GEN4_TO_CONTROLLER_LOG:GEN4_CONNECT_INT_LOG Pre:SetPowerInfo
549 1764432049025 GEN4_TO_CONTROLLER_LOG:GEN4_CONNECT_INT_LOG Payload
549 1764432049025 GEN4_TO_CONTROLLER_LOG:GEN4_CONNECT_INT_LOG PowerInfo: Values:
549 1764432049025 GEN4_TO_CONTROLLER_LOG:GEN4_CONNECT_INT_LOG PowerInfo: shotDownSystem = false, isToolPower = false, voltage = 5.000000, useVppFirst = false, useLowVoltageProgramming = true, useMaintainActivePower = false
549 1764432049025 GEN4_TO_CONTROLLER_LOG:GEN4_CONNECT_INT_LOG Payload End
549 1764432049025 NativeController::GetVoltageInfo entry
549 1764432049025 pro JtagIce3 [0x01] <<< 02 00 01 00 02 
549 1764432049036 pro JtagIce3 [0x01] >>> 84 01 88 13 00 
549 1764432049036 pro JtagIce3 [0x01] <<< 02 00 01 20 02 
549 1764432049052 pro JtagIce3 [0x01] >>> 84 01 00 00 11 
549 1764432049052 NativeController::GetVoltageInfo TSUP exit with exception + The requested command is not supported. (17)
549 1764432049052 pro JtagIce3 [0x01] <<< 02 00 01 02 02 
549 1764432049068 pro JtagIce3 [0x01] >>> 84 01 00 00 11 
549 1764432049068 NativeController::GetVoltageInfo VUSB exit with exception + The requested command is not supported. (17)
549 1764432049068 NativeController::GetVoltageInfo exit
549 1764432049068 GEN4_TO_CONTROLLER_LOG:GEN4_CONNECT_INT_LOG Post:SetPowerInfo
549 1764432049068 GEN4_TO_CONTROLLER_LOG:GEN4_CONNECT_INT_LOG Return Value
549 1764432049068 GEN4_TO_CONTROLLER_LOG:GEN4_CONNECT_INT_LOG none
549 1764432049068 GEN4_TO_CONTROLLER_LOG:GEN4_CONNECT_INT_LOG Return End

549 1764432049068 GEN4_TO_CONTROLLER_LOG:GEN4_CONNECT_INT_LOG Pre:GetVoltageInfo
549 1764432049068 GEN4_TO_CONTROLLER_LOG:GEN4_CONNECT_INT_LOG Payload
549 1764432049068 GEN4_TO_CONTROLLER_LOG:GEN4_CONNECT_INT_LOG null
549 1764432049068 GEN4_TO_CONTROLLER_LOG:GEN4_CONNECT_INT_LOG Payload End
549 1764432049068 NativeController::GetVoltageInfo entry
549 1764432049068 pro JtagIce3 [0x01] <<< 02 00 01 00 02 
549 1764432049083 pro JtagIce3 [0x01] >>> 84 01 88 13 00 
549 1764432049083 pro JtagIce3 [0x01] <<< 02 00 01 20 02 
549 1764432049100 pro JtagIce3 [0x01] >>> 84 01 00 00 11 
549 1764432049100 NativeController::GetVoltageInfo TSUP exit with exception + The requested command is not supported. (17)
549 1764432049100 pro JtagIce3 [0x01] <<< 02 00 01 02 02 
549 1764432049116 pro JtagIce3 [0x01] >>> 84 01 00 00 11 
549 1764432049116 NativeController::GetVoltageInfo VUSB exit with exception + The requested command is not supported. (17)
549 1764432049116 NativeController::GetVoltageInfo exit
549 1764432049116 GEN4_TO_CONTROLLER_LOG:GEN4_CONNECT_INT_LOG Post:GetVoltageInfo
549 1764432049116 GEN4_TO_CONTROLLER_LOG:GEN4_CONNECT_INT_LOG Return Value
549 1764432049116 GEN4_TO_CONTROLLER_LOG:GEN4_CONNECT_INT_LOG VoltagesInfo: Values:
549 1764432049116 GEN4_TO_CONTROLLER_LOG:GEN4_CONNECT_INT_LOG VoltagesInfo: internalVdd = 0, internalVpp = 0, targetVdd = 0, targetVpp = -2147483648, vddSense = 5000, temp = 0, vddCurrentSense = 0, vddVoltageSense = -2147483648
549 1764432049116 GEN4_TO_CONTROLLER_LOG:GEN4_CONNECT_INT_LOG Return End

549 1764432049116 GEN4_TO_CONTROLLER_LOG:GEN4_CONNECT_INT_LOG Pre:SetLEDBrightness
549 1764432049116 GEN4_TO_CONTROLLER_LOG:GEN4_CONNECT_INT_LOG Payload
549 1764432049116 GEN4_TO_CONTROLLER_LOG:GEN4_CONNECT_INT_LOG 5
549 1764432049116 GEN4_TO_CONTROLLER_LOG:GEN4_CONNECT_INT_LOG Payload End
549 1764432049116 GEN4_TO_CONTROLLER_LOG:GEN4_CONNECT_INT_LOG Post:SetLEDBrightness
549 1764432049116 GEN4_TO_CONTROLLER_LOG:GEN4_CONNECT_INT_LOG Return Value
549 1764432049116 GEN4_TO_CONTROLLER_LOG:GEN4_CONNECT_INT_LOG none
549 1764432049116 GEN4_TO_CONTROLLER_LOG:GEN4_CONNECT_INT_LOG Return End

549 1764432049116 GEN4_TO_CONTROLLER_LOG:GEN4_CONNECT_INT_LOG Pre:SetToolInfo
549 1764432049116 GEN4_TO_CONTROLLER_LOG:GEN4_CONNECT_INT_LOG Payload
549 1764432049116 GEN4_TO_CONTROLLER_LOG:GEN4_CONNECT_INT_LOG ToolInfo: Values:
549 1764432049116 GEN4_TO_CONTROLLER_LOG:GEN4_CONNECT_INT_LOG ToolInfo: speedLevel = 1, PGCResistance = 4700, PGDResistance = 4700, PGCPullDir = PullDown, PGDPullDir = PullDown, ICSPSelected = Wire2
549 1764432049116 GEN4_TO_CONTROLLER_LOG:GEN4_CONNECT_INT_LOG Payload End
549 1764432049116 GEN4_TO_CONTROLLER_LOG:GEN4_CONNECT_INT_LOG Post:SetToolInfo
549 1764432049116 GEN4_TO_CONTROLLER_LOG:GEN4_CONNECT_INT_LOG Return Value
549 1764432049116 GEN4_TO_CONTROLLER_LOG:GEN4_CONNECT_INT_LOG none
549 1764432049116 GEN4_TO_CONTROLLER_LOG:GEN4_CONNECT_INT_LOG Return End

549 1764432049117 GEN4_TO_CONTROLLER_LOG:GEN4_CONNECT_INT_LOG Pre:GetTargetIDInfo
549 1764432049117 GEN4_TO_CONTROLLER_LOG:GEN4_CONNECT_INT_LOG Payload
549 1764432049117 GEN4_TO_CONTROLLER_LOG:GEN4_CONNECT_INT_LOG null
549 1764432049117 GEN4_TO_CONTROLLER_LOG:GEN4_CONNECT_INT_LOG Payload End
549 1764432049117 NativeController::GetTargetIDInfo entry
549 1764432049117 pro JtagIce3 [0x12] <<< 01 00 00 00 01 01 
549 1764432049132 pro JtagIce3 [0x12] >>> 80 00 
549 1764432049132 pro JtagIce3 [0x12] <<< 01 00 00 01 04 01 00 00 00 
549 1764432049148 pro JtagIce3 [0x12] >>> 80 00 
549 1764432049148 pro JtagIce3 [0x12] <<< 01 00 01 00 01 01 
549 1764432049163 pro JtagIce3 [0x12] >>> 80 00 
549 1764432049163 pro JtagIce3 [0x11] <<< 1D 7D 00 
549 1764432049180 pro JtagIce3 [0x11] >>> 1D 00 
549 1764432049180 pro JtagIce3 [0x11] <<< 10 C8 64 19 20 00 53 03 AC 53 00 00 
549 1764432049284 pro JtagIce3 [0x11] >>> 10 00 
549 1764432049284 pro JtagIce3 [0x11] <<< 1B 04 30 00 00 00 
549 1764432049300 pro JtagIce3 [0x11] >>> 1B 00 1E 00 
549 1764432049300 pro JtagIce3 [0x11] <<< 1B 04 30 00 01 00 
549 1764432049316 pro JtagIce3 [0x11] >>> 1B 00 95 00 
549 1764432049316 pro JtagIce3 [0x11] <<< 1B 04 30 00 02 00 
549 1764432049332 pro JtagIce3 [0x11] >>> 1B 00 16 00 
549 1764432049332 pro JtagIce3 [0x11] <<< 1B 04 30 00 00 00 
549 1764432049348 pro JtagIce3 [0x11] >>> 1B 00 1E 00 
549 1764432049348 pro JtagIce3 [0x11] <<< 1B 04 30 00 01 00 
549 1764432049364 pro JtagIce3 [0x11] >>> 1B 00 95 00 
549 1764432049364 pro JtagIce3 [0x11] <<< 1B 04 30 00 02 00 
549 1764432049380 pro JtagIce3 [0x11] >>> 1B 00 16 00 
549 1764432049380 pro JtagIce3 [0x11] <<< 1B 04 30 00 00 00 
549 1764432049396 pro JtagIce3 [0x11] >>> 1B 00 1E 00 
549 1764432049396 pro JtagIce3 [0x11] <<< 1B 04 30 00 01 00 
549 1764432049412 pro JtagIce3 [0x11] >>> 1B 00 95 00 
549 1764432049412 pro JtagIce3 [0x11] <<< 1B 04 30 00 02 00 
549 1764432049428 pro JtagIce3 [0x11] >>> 1B 00 16 00 
549 1764432049428 pro JtagIce3 [0x11] <<< 11 01 01 
549 1764432049444 pro JtagIce3 [0x11] >>> 11 00 
549 1764432049444 pro JtagIce3 [0x01] <<< 11 00 00 
549 1764432049460 pro JtagIce3 [0x01] >>> 80 00 
549 1764432049460 NativeController::GetTargetIDInfo exit device ID 0x1e9516
549 1764432049460 GEN4_TO_CONTROLLER_LOG:GEN4_CONNECT_INT_LOG Post:GetTargetIDInfo
549 1764432049460 GEN4_TO_CONTROLLER_LOG:GEN4_CONNECT_INT_LOG Return Value
549 1764432049460 GEN4_TO_CONTROLLER_LOG:GEN4_CONNECT_INT_LOG TargetIDInfo: Values:
549 1764432049460 GEN4_TO_CONTROLLER_LOG:GEN4_CONNECT_INT_LOG TargetIDInfo: DeviceID = 001e9516
549 1764432049460 GEN4_TO_CONTROLLER_LOG:GEN4_CONNECT_INT_LOG Return End

549 1764432049465 GEN4_TO_CONTROLLER_LOG:GEN4_PROGRAM_INT_LOG_ATmega328PB Pre:SendOperation
549 1764432049465 GEN4_TO_CONTROLLER_LOG:GEN4_PROGRAM_INT_LOG_ATmega328PB Payload
549 1764432049465 GEN4_TO_CONTROLLER_LOG:GEN4_PROGRAM_INT_LOG_ATmega328PB OperationInfo: Values:
549 1764432049465 GEN4_TO_CONTROLLER_LOG:GEN4_PROGRAM_INT_LOG_ATmega328PB OperationInfo: Type = erase, Mask = 00000000, Erase = false, Production Mode = true
549 1764432049465 GEN4_TO_CONTROLLER_LOG:GEN4_PROGRAM_INT_LOG_ATmega328PB TransferInfo: Start = 0, End = 7fff, Buffer Length = 0, Type = Pgm, Mask = 00000000
549 1764432049465 GEN4_TO_CONTROLLER_LOG:GEN4_PROGRAM_INT_LOG_ATmega328PB TransferInfo: Start = 820000, End = 820002, Buffer Length = 0, Type = Cfg, Mask = 00000000
549 1764432049465 GEN4_TO_CONTROLLER_LOG:GEN4_PROGRAM_INT_LOG_ATmega328PB TransferInfo: Start = 830000, End = 830000, Buffer Length = 0, Type = Cfg, Mask = 00000000
549 1764432049465 GEN4_TO_CONTROLLER_LOG:GEN4_PROGRAM_INT_LOG_ATmega328PB TransferInfo: Start = 0, End = 3ff, Buffer Length = 0, Type = DataFlash, Mask = 00000000
549 1764432049465 GEN4_TO_CONTROLLER_LOG:GEN4_PROGRAM_INT_LOG_ATmega328PB Payload End
549 1764432049465 pro JtagIce3 [0x12] <<< 01 00 00 00 01 01 
549 1764432049476 pro JtagIce3 [0x12] >>> 80 00 
549 1764432049476 pro JtagIce3 [0x12] <<< 01 00 00 01 04 01 00 00 00 
549 1764432049492 pro JtagIce3 [0x12] >>> 80 00 
549 1764432049492 pro JtagIce3 [0x12] <<< 01 00 01 00 01 01 
549 1764432049508 pro JtagIce3 [0x12] >>> 80 00 
549 1764432049508 pro JtagIce3 [0x11] <<< 1D 7D 00 
549 1764432049524 pro JtagIce3 [0x11] >>> 1D 00 
549 1764432049524 pro JtagIce3 [0x11] <<< 10 C8 64 19 20 00 53 03 AC 53 00 00 
549 1764432049628 pro JtagIce3 [0x11] >>> 10 00 
549 1764432049628 pro JtagIce3 [0x11] <<< 1B 04 30 00 00 00 
549 1764432049644 pro JtagIce3 [0x11] >>> 1B 00 1E 00 
549 1764432049644 pro JtagIce3 [0x11] <<< 1B 04 30 00 01 00 
549 1764432049660 pro JtagIce3 [0x11] >>> 1B 00 95 00 
549 1764432049660 pro JtagIce3 [0x11] <<< 1B 04 30 00 02 00 
549 1764432049676 pro JtagIce3 [0x11] >>> 1B 00 16 00 
549 1764432049676 pro JtagIce3 [0x11] <<< 12 2D 01 AC 80 00 00 
549 1764432049692 pro JtagIce3 [0x11] >>> 12 00 
549 1764432049692 pro JtagIce3 [0x11] <<< 18 04 58 08 00 00 
549 1764432049707 pro JtagIce3 [0x11] >>> 18 00 DF 00 
549 1764432049758 pro JtagIce3 [0x11] <<< 17 AC A8 00 DF 
549 1764432049772 pro JtagIce3 [0x11] >>> 17 00 
549 1764432049797 pro JtagIce3 [0x11] <<< 12 2D 01 AC 80 00 00 
549 1764432049812 pro JtagIce3 [0x11] >>> 12 00 
549 1764432049812 GEN4_TO_CONTROLLER_LOG:GEN4_PROGRAM_INT_LOG_ATmega328PB Post:SendOperation
549 1764432049812 GEN4_TO_CONTROLLER_LOG:GEN4_PROGRAM_INT_LOG_ATmega328PB Return Value
549 1764432049812 GEN4_TO_CONTROLLER_LOG:GEN4_PROGRAM_INT_LOG_ATmega328PB None
549 1764432049812 GEN4_TO_CONTROLLER_LOG:GEN4_PROGRAM_INT_LOG_ATmega328PB Return End

549 1764432049814 GEN4_TO_CONTROLLER_LOG:GEN4_PROGRAM_INT_LOG_ATmega328PB Pre:SendOperation
549 1764432049814 GEN4_TO_CONTROLLER_LOG:GEN4_PROGRAM_INT_LOG_ATmega328PB Payload
549 1764432049814 GEN4_TO_CONTROLLER_LOG:GEN4_PROGRAM_INT_LOG_ATmega328PB OperationInfo: Values:
549 1764432049814 GEN4_TO_CONTROLLER_LOG:GEN4_PROGRAM_INT_LOG_ATmega328PB OperationInfo: Type = write, Mask = 00000000, Erase = false, Production Mode = true
549 1764432049814 GEN4_TO_CONTROLLER_LOG:GEN4_PROGRAM_INT_LOG_ATmega328PB TransferInfo: Start = 0, End = bff, Buffer Length = 3072, Type = Pgm, Mask = 00000000
549 1764432049814 GEN4_TO_CONTROLLER_LOG:GEN4_PROGRAM_INT_LOG_ATmega328PB Payload End
549 1764432049814 pro JtagIce3 [0x11] <<< 06 00 00 00 00 
549 1764432049828 pro JtagIce3 [0x11] >>> 06 00 
549 1764432049828 pro JtagIce3 [0x11] <<< 13 00 80 C1 0A 40 4C 20 00 00 0C 94 69 00 0C 94 9D 05 0C 94 9D 05 0C 94 9D 05 0C 94 9D 05 0C 94 9D 05 0C 94 9D 05 0C 94 9D 05 0C 94 9D 05 0C 94 9D 05 0C 94 9D 05 0C 94 9D 05 0C 94 9D 05 0C 94 9D 05 0C 94 9D 05 0C 94 9D 05 0C 94 9D 05 0C 94 9D 05 0C 94 9D 05 0C 94 9D 05 0C 94 9D 05 0C 94 9D 05 0C 94 9D 05 0C 94 9D 05 0C 94 9D 05 0C 94 9D 05 0C 94 9D 05 0C 94 9D 05 0C 94 9D 05 0C 94 9D 05 0C 94 9D 05 0C 94 9D 05 
549 1764432049931 pro JtagIce3 [0x11] >>> 13 00 
549 1764432049931 pro JtagIce3 [0x11] <<< 06 00 00 00 40 
549 1764432049946 pro JtagIce3 [0x11] >>> 06 00 
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
549 1764432055498 GEN4_TO_CONTROLLER_LOG:GEN4_PROGRAM_INT_LOG_ATmega328PB Return Value
549 1764432055498 GEN4_TO_CONTROLLER_LOG:GEN4_PROGRAM_INT_LOG_ATmega328PB None
549 1764432055498 GEN4_TO_CONTROLLER_LOG:GEN4_PROGRAM_INT_LOG_ATmega328PB Return End

549 1764432055499 GEN4_TO_CONTROLLER_LOG:GEN4_PROGRAM_INT_LOG_ATmega328PB Pre:SendOperation
549 1764432055499 GEN4_TO_CONTROLLER_LOG:GEN4_PROGRAM_INT_LOG_ATmega328PB Payload
549 1764432055499 GEN4_TO_CONTROLLER_LOG:GEN4_PROGRAM_INT_LOG_ATmega328PB OperationInfo: Values:
549 1764432055499 GEN4_TO_CONTROLLER_LOG:GEN4_PROGRAM_INT_LOG_ATmega328PB OperationInfo: Type = releasefromreset, Mask = 00000000, Erase = false, Production Mode = true
549 1764432055499 GEN4_TO_CONTROLLER_LOG:GEN4_PROGRAM_INT_LOG_ATmega328PB Payload End
549 1764432055499 pro JtagIce3 [0x01] <<< 11 00 00 
549 1764432055513 pro JtagIce3 [0x01] >>> 80 00 
549 1764432055513 GEN4_TO_CONTROLLER_LOG:GEN4_PROGRAM_INT_LOG_ATmega328PB Post:SendOperation
549 1764432055513 GEN4_TO_CONTROLLER_LOG:GEN4_PROGRAM_INT_LOG_ATmega328PB Return Value
549 1764432055513 GEN4_TO_CONTROLLER_LOG:GEN4_PROGRAM_INT_LOG_ATmega328PB None
549 1764432055513 GEN4_TO_CONTROLLER_LOG:GEN4_PROGRAM_INT_LOG_ATmega328PB Return End
549 1764432055514 GEN4_CONNECT_DIAGNOSTICS:MPLABCommTool is null

549 1764432055514 GEN4_TO_CONTROLLER_LOG:GEN4_CONNECT_INT_LOG Pre:GetFirmwareInfo
549 1764432055514 GEN4_TO_CONTROLLER_LOG:GEN4_CONNECT_INT_LOG Payload
549 1764432055514 GEN4_TO_CONTROLLER_LOG:GEN4_CONNECT_INT_LOG null
549 1764432055514 GEN4_TO_CONTROLLER_LOG:GEN4_CONNECT_INT_LOG Payload End
549 1764432055514 NativeController::GetFirmwareInfo entry
549 1764432055514 pro JtagIce3 [0x01] <<< 02 00 00 00 01 
549 1764432055530 pro JtagIce3 [0x01] >>> 84 01 00 00 
549 1764432055530 NativeController::getFirmwareVersion entry
549 1764432055530 pro JtagIce3 [0x01] <<< 02 00 00 01 01 
549 1764432055546 pro JtagIce3 [0x01] >>> 84 01 01 00 
549 1764432055546 pro JtagIce3 [0x01] <<< 02 00 00 02 01 
549 1764432055561 pro JtagIce3 [0x01] >>> 84 01 16 00 
549 1764432055561 pro JtagIce3 [0x01] <<< 02 00 00 03 02 
549 1764432055577 pro JtagIce3 [0x01] >>> 84 01 86 00 00 
549 1764432055577 NativeController::getFirmwareVersion exit
549 1764432055577 pro JtagIce3 [0x01] <<< 02 00 00 09 01 
549 1764432055593 pro JtagIce3 [0x01] >>> 84 01 FF 00 
549 1764432055593 NativeController::tryGetFPGAVersion entry
549 1764432055593 pro JtagIce3 [0x01] <<< 02 00 00 10 01 
549 1764432055610 pro JtagIce3 [0x01] >>> 84 01 00 11 
549 1764432055610 pro JtagIce3 [0x01] <<< 02 00 00 11 01 
549 1764432055626 pro JtagIce3 [0x01] >>> 84 01 00 11 
549 1764432055626 pro JtagIce3 [0x01] <<< 02 00 00 12 01 
549 1764432055642 pro JtagIce3 [0x01] >>> 84 01 00 11 
549 1764432055642 NativeController::tryGetFPGAVersion exit
549 1764432055642 NativeController::tryGetFPGAVersion exit with exception No value present
549 1764432055642 pro JtagIce3 [0x01] <<< 02 00 00 06 01 
549 1764432055658 pro JtagIce3 [0x01] >>> 84 01 01 00 
549 1764432055658 pro JtagIce3 [0x01] <<< 02 00 00 07 01 
549 1764432055674 pro JtagIce3 [0x01] >>> 84 01 00 00 
549 1764432055674 pro JtagIce3 [0x01] <<< 02 00 00 0A 01 
549 1764432055689 pro JtagIce3 [0x01] >>> 84 01 00 11 
549 1764432055690 NativeController::GetFirmwareInfo exit
549 1764432055690 GEN4_TO_CONTROLLER_LOG:GEN4_CONNECT_INT_LOG Post:GetFirmwareInfo
549 1764432055690 GEN4_TO_CONTROLLER_LOG:GEN4_CONNECT_INT_LOG Return Value
549 1764432055690 GEN4_TO_CONTROLLER_LOG:GEN4_CONNECT_INT_LOG FirmwareInfo: Values:
549 1764432055690 GEN4_TO_CONTROLLER_LOG:GEN4_CONNECT_INT_LOG FirmwareInfo: boot = false, bootVer = 1.0.0 (0x01.0x00.0x00), apVer = 1.22.134 (0x01.0x16.0x86), fpgaVer = null, scriptVer = null, macAddress = , devID = 0, devID1 = 0, devSN0 = 0, devSN1 = 0, serialNumber = null, appCommitID = null, scriptCommitID = null, PCB_ID = 0
549 1764432055690 GEN4_TO_CONTROLLER_LOG:GEN4_CONNECT_INT_LOG Return End

549 1764432055690 GEN4_TO_CONTROLLER_LOG:GEN4_CONNECT_INT_LOG Pre:SetPowerInfo
549 1764432055690 GEN4_TO_CONTROLLER_LOG:GEN4_CONNECT_INT_LOG Payload
549 1764432055690 GEN4_TO_CONTROLLER_LOG:GEN4_CONNECT_INT_LOG PowerInfo: Values:
549 1764432055690 GEN4_TO_CONTROLLER_LOG:GEN4_CONNECT_INT_LOG PowerInfo: shotDownSystem = true, isToolPower = false, voltage = 0.000000, useVppFirst = false, useLowVoltageProgramming = true, useMaintainActivePower = false
549 1764432055690 GEN4_TO_CONTROLLER_LOG:GEN4_CONNECT_INT_LOG Payload End
549 1764432055690 NativeController::GetVoltageInfo entry
549 1764432055690 pro JtagIce3 [0x01] <<< 02 00 01 00 02 
549 1764432055706 pro JtagIce3 [0x01] >>> 84 01 88 13 00 
549 1764432055706 pro JtagIce3 [0x01] <<< 02 00 01 20 02 
549 1764432055722 pro JtagIce3 [0x01] >>> 84 01 00 00 11 
549 1764432055722 NativeController::GetVoltageInfo TSUP exit with exception + The requested command is not supported. (17)
549 1764432055722 pro JtagIce3 [0x01] <<< 02 00 01 02 02 
549 1764432055738 pro JtagIce3 [0x01] >>> 84 01 00 00 11 
549 1764432055738 NativeController::GetVoltageInfo VUSB exit with exception + The requested command is not supported. (17)
549 1764432055738 NativeController::GetVoltageInfo exit
549 1764432055738 GEN4_TO_CONTROLLER_LOG:GEN4_CONNECT_INT_LOG Post:SetPowerInfo
549 1764432055738 GEN4_TO_CONTROLLER_LOG:GEN4_CONNECT_INT_LOG Return Value
549 1764432055738 GEN4_TO_CONTROLLER_LOG:GEN4_CONNECT_INT_LOG none
549 1764432055738 GEN4_TO_CONTROLLER_LOG:GEN4_CONNECT_INT_LOG Return End

549 1764432055738 GEN4_TO_CONTROLLER_LOG:GEN4_CONNECT_INT_LOG Pre:Disconnect
549 1764432055738 GEN4_TO_CONTROLLER_LOG:GEN4_CONNECT_INT_LOG Payload
549 1764432055738 GEN4_TO_CONTROLLER_LOG:GEN4_CONNECT_INT_LOG Payload End
549 1764432055738 NativeController::Disconnect entry
549 1764432055738 pro JtagIce3 [0x01] <<< 11 00 00 
549 1764432055754 pro JtagIce3 [0x01] >>> 80 00 
549 1764432055754 NativeController::Disconnect exit
549 1764432055754 GEN4_TO_CONTROLLER_LOG:GEN4_CONNECT_INT_LOG Post:Disconnect
549 1764432055754 GEN4_TO_CONTROLLER_LOG:GEN4_CONNECT_INT_LOG Return Value
549 1764432055754 GEN4_TO_CONTROLLER_LOG:GEN4_CONNECT_INT_LOG none
549 1764432055754 GEN4_TO_CONTROLLER_LOG:GEN4_CONNECT_INT_LOG Return End
549 1764432055754 GEN4_CONNECT_DIAGNOSTICS:Removing plug and play observer com.microchip.mplab.mdbcore.RI4Tool.RI4ToolBase$RI4PlugNPlayObserver@63bbace1
549 1764432055754 GEN4_CONNECT_DIAGNOSTICS:Begin PlugNPlayObservers list dump:
549 1764432055754 GEN4_CONNECT_DIAGNOSTICS:End PlugNPlayObservers list dump:
549 1764432055855 GEN4_CONNECT_DIAGNOSTICS:Calling RIDbgToolCom.Disconnect
549 1764432055855 GEN4_CONNECT_DIAGNOSTICS:Calling MPLABCommTool.Detach to remove tool from plug and play list
549 1764432055855 GEN4_CONNECT_DIAGNOSTICS:Calling RIDbgToolCom.DisconnectFromMPlabComm
549 1764432055855 GEN4_CONNECT_DIAGNOSTICS:Calling MPLABCommTool.Disconnect
565 1764432105025 GEN4_CONNECT_DIAGNOSTICS:MPLABCommTool is NOT null
565 1764432105025 GEN4_CONNECT_DIAGNOSTICS:AttachedToolPID = 2145, AttachedToolVID = 3eb
565 1764432105025 GEN4_CONNECT_DIAGNOSTICS:transport type = USB
565 1764432105025 GEN4_CONNECT_DIAGNOSTICS:AttachedToolPID = 2145, AttachedToolVID = 3eb
565 1764432105027 com.microchip.mplab.mdbcore.RealICETool.RIDbgToolCom
565 1764432105027 GEN4_CONNECT_DIAGNOSTICS:Before MPLABCommTool.Connect()
565 1764432105027 GEN4_CONNECT_DIAGNOSTICS:After MPLABCommTool.Connect()
565 1764432105027 GEN4_CONNECT_DIAGNOSTICS:MPLABCommTool.Connect() returned MPLABCOMM_NO_ERROR
565 1764432105027 GEN4_CONNECT_DIAGNOSTICS:Attaching to MPLABCommTool plugnplay
565 1764432105027 GEN4_CONNECT_DIAGNOSTICS:Adding new plug and play observer com.microchip.mplab.mdbcore.RI4Tool.RI4ToolBase$RI4PlugNPlayObserver@6825d1d3
565 1764432105027 GEN4_CONNECT_DIAGNOSTICS:Begin PlugNPlayObservers list dump:
565 1764432105027 GEN4_CONNECT_DIAGNOSTICS:com.microchip.mplab.mdbcore.RI4Tool.RI4ToolBase$RI4PlugNPlayObserver@6825d1d3
565 1764432105027 GEN4_CONNECT_DIAGNOSTICS:End PlugNPlayObservers list dump:
565 1764432105027 GEN4_CONNECT_DIAGNOSTICS:Registering for alternate PNP notifications. CommPnPCriteria.cPIDList = [2ff4], CommPnPCriteria.cSerialNumber = atml2523052700011486

565 1764432105048 GEN4_TO_CONTROLLER_LOG:GEN4_INIT_INT_LOG_ATmega328PB Pre:init
565 1764432105048 GEN4_TO_CONTROLLER_LOG:GEN4_INIT_INT_LOG_ATmega328PB Payload
565 1764432105048 GEN4_TO_CONTROLLER_LOG:GEN4_INIT_INT_LOG_ATmega328PB DeviceInfo: Values:
565 1764432105048 GEN4_TO_CONTROLLER_LOG:GEN4_INIT_INT_LOG_ATmega328PB DeviceInfo: pcAddress = 7fffffffffffffff, Vpp = 5.00, useRowEraseIfVoltageIsLow = false, voltageBelowWhichUseRowErase = 0.00, deviceName = ATmega328PB, programmerType = 
565 1764432105048 GEN4_TO_CONTROLLER_LOG:GEN4_INIT_INT_LOG_ATmega328PB DeviceInfo: MemInfo values:
565 1764432105048 GEN4_TO_CONTROLLER_LOG:GEN4_INIT_INT_LOG_ATmega328PB DeviceInfo: mask = ffff, exists = true, startAddr = 00000000, endAddr = 00007fff, rowSize = 0080, rowEraseSize = 0080, addrInc = 0001, widthProgram = 0001
565 1764432105048 GEN4_TO_CONTROLLER_LOG:GEN4_INIT_INT_LOG_ATmega328PB DeviceInfo: mask = 00ff, exists = true, startAddr = 00820000, endAddr = 00820002, rowSize = 0001, rowEraseSize = 0000, addrInc = 0001, widthProgram = 0001
565 1764432105048 GEN4_TO_CONTROLLER_LOG:GEN4_INIT_INT_LOG_ATmega328PB DeviceInfo: mask = 0000, exists = false, startAddr = 00000000, endAddr = 00000000, rowSize = 0000, rowEraseSize = 0000, addrInc = 0000, widthProgram = 0000
565 1764432105048 GEN4_TO_CONTROLLER_LOG:GEN4_INIT_INT_LOG_ATmega328PB DeviceInfo: mask = 0000, exists = false, startAddr = 00000000, endAddr = 00000000, rowSize = 0000, rowEraseSize = 0000, addrInc = 0000, widthProgram = 0000
565 1764432105048 GEN4_TO_CONTROLLER_LOG:GEN4_INIT_INT_LOG_ATmega328PB DeviceInfo: mask = 0000, exists = false, startAddr = 00000000, endAddr = 00000000, rowSize = 0000, rowEraseSize = 0000, addrInc = 0000, widthProgram = 0000
565 1764432105048 GEN4_TO_CONTROLLER_LOG:GEN4_INIT_INT_LOG_ATmega328PB DeviceInfo: mask = 0000, exists = false, startAddr = 00000000, endAddr = 00000000, rowSize = 0000, rowEraseSize = 0080, addrInc = 0000, widthProgram = 0000
565 1764432105048 GEN4_TO_CONTROLLER_LOG:GEN4_INIT_INT_LOG_ATmega328PB DeviceInfo: mask = 0000, exists = false, startAddr = 00000000, endAddr = 00000000, rowSize = 0000, rowEraseSize = 0000, addrInc = 0001, widthProgram = 0001
565 1764432105048 GEN4_TO_CONTROLLER_LOG:GEN4_INIT_INT_LOG_ATmega328PB DeviceInfo: mask = 0000, exists = false, startAddr = 00000000, endAddr = 00000000, rowSize = 0000, rowEraseSize = 0000, addrInc = 0000, widthProgram = 0000
565 1764432105048 GEN4_TO_CONTROLLER_LOG:GEN4_INIT_INT_LOG_ATmega328PB DeviceInfo: mask = 00ff, exists = true, startAddr = 00000000, endAddr = 000003ff, rowSize = 0004, rowEraseSize = 0000, addrInc = 0001, widthProgram = 0001
565 1764432105048 GEN4_TO_CONTROLLER_LOG:GEN4_INIT_INT_LOG_ATmega328PB DeviceInfo: mask = 0000, exists = false, startAddr = 00000000, endAddr = 00000000, rowSize = 0000, rowEraseSize = 0000, addrInc = 0000, widthProgram = 0000
565 1764432105048 GEN4_TO_CONTROLLER_LOG:GEN4_INIT_INT_LOG_ATmega328PB DeviceInfo: mask = 0000, exists = false, startAddr = 00000000, endAddr = 00000000, rowSize = 0000, rowEraseSize = 0000, addrInc = 0000, widthProgram = 0000
565 1764432105048 GEN4_TO_CONTROLLER_LOG:GEN4_INIT_INT_LOG_ATmega328PB DeviceInfo: mask = 0000, exists = false, startAddr = 00000000, endAddr = 00000000, rowSize = 0000, rowEraseSize = 0000, addrInc = 0001, widthProgram = 0001
565 1764432105048 GEN4_TO_CONTROLLER_LOG:GEN4_INIT_INT_LOG_ATmega328PB DeviceInfo: mask = 0000, exists = false, startAddr = 00000000, endAddr = 00000000, rowSize = 0000, rowEraseSize = 0000, addrInc = 0000, widthProgram = 0000
565 1764432105048 GEN4_TO_CONTROLLER_LOG:GEN4_INIT_INT_LOG_ATmega328PB DeviceInfo: mask = 0000, exists = false, startAddr = 00000000, endAddr = 00000000, rowSize = 0000, rowEraseSize = 0000, addrInc = 0000, widthProgram = 0000
565 1764432105048 GEN4_TO_CONTROLLER_LOG:GEN4_INIT_INT_LOG_ATmega328PB DeviceInfo: mask = 0000, exists = false, startAddr = 00000000, endAddr = 00000000, rowSize = 0000, rowEraseSize = 0000, addrInc = 0000, widthProgram = 0000
565 1764432105048 GEN4_TO_CONTROLLER_LOG:GEN4_INIT_INT_LOG_ATmega328PB DeviceInfo: mask = 0000, exists = false, startAddr = 00000000, endAddr = 00000000, rowSize = 0000, rowEraseSize = 0000, addrInc = 0000, widthProgram = 0000
565 1764432105048 GEN4_TO_CONTROLLER_LOG:GEN4_INIT_INT_LOG_ATmega328PB DeviceInfo: mask = 7fffffff, exists = true, startAddr = 00840000, endAddr = 00840002, rowSize = 0001, rowEraseSize = 0000, addrInc = 0001, widthProgram = 0001
565 1764432105048 GEN4_TO_CONTROLLER_LOG:GEN4_INIT_INT_LOG_ATmega328PB DeviceInfo: mask = 0000, exists = false, startAddr = 00000000, endAddr = 00000000, rowSize = 0000, rowEraseSize = 0000, addrInc = 0000, widthProgram = 0000
565 1764432105048 GEN4_TO_CONTROLLER_LOG:GEN4_INIT_INT_LOG_ATmega328PB DeviceInfo: mask = 0000, exists = false, startAddr = 00000000, endAddr = 00000000, rowSize = 0000, rowEraseSize = 0000, addrInc = 0000, widthProgram = 0000
565 1764432105048 GEN4_TO_CONTROLLER_LOG:GEN4_INIT_INT_LOG_ATmega328PB DeviceInfo: mask = 0000, exists = false, startAddr = 00000000, endAddr = 00000000, rowSize = 0000, rowEraseSize = 0000, addrInc = 0000, widthProgram = 0000
565 1764432105048 GEN4_TO_CONTROLLER_LOG:GEN4_INIT_INT_LOG_ATmega328PB DeviceInfo: mask = 0000, exists = false, startAddr = 00000000, endAddr = 00000000, rowSize = 0000, rowEraseSize = 0000, addrInc = 0000, widthProgram = 0000
565 1764432105048 GEN4_TO_CONTROLLER_LOG:GEN4_INIT_INT_LOG_ATmega328PB DeviceInfo: mask = 0000, exists = false, startAddr = 00000000, endAddr = 00000000, rowSize = 0000, rowEraseSize = 0000, addrInc = 0000, widthProgram = 0000
565 1764432105048 GEN4_TO_CONTROLLER_LOG:GEN4_INIT_INT_LOG_ATmega328PB DeviceInfo: mask = 0000, exists = false, startAddr = 00000000, endAddr = 00000000, rowSize = 0000, rowEraseSize = 0000, addrInc = 0000, widthProgram = 0000
565 1764432105048 GEN4_TO_CONTROLLER_LOG:GEN4_INIT_INT_LOG_ATmega328PB DeviceInfo: CfgRequiredBitsMask Values:
565 1764432105048 GEN4_TO_CONTROLLER_LOG:GEN4_INIT_INT_LOG_ATmega328PB Address = 00820000, Mask = 000000ff
565 1764432105048 GEN4_TO_CONTROLLER_LOG:GEN4_INIT_INT_LOG_ATmega328PB Address = 00820001, Mask = 000000ff
565 1764432105048 GEN4_TO_CONTROLLER_LOG:GEN4_INIT_INT_LOG_ATmega328PB Address = 00820002, Mask = 0000000f
565 1764432105048 GEN4_TO_CONTROLLER_LOG:GEN4_INIT_INT_LOG_ATmega328PB Address = 00830000, Mask = 0000003f
565 1764432105048 GEN4_TO_CONTROLLER_LOG:GEN4_INIT_INT_LOG_ATmega328PB BasicInfo: Values:
565 1764432105048 GEN4_TO_CONTROLLER_LOG:GEN4_INIT_INT_LOG_ATmega328PB Payload End
565 1764432105048 GEN4_TO_CONTROLLER_LOG:GEN4_INIT_INT_LOG_ATmega328PB Post:init
565 1764432105048 GEN4_TO_CONTROLLER_LOG:GEN4_INIT_INT_LOG_ATmega328PB Return Value
565 1764432105048 GEN4_TO_CONTROLLER_LOG:GEN4_INIT_INT_LOG_ATmega328PB none
565 1764432105048 GEN4_TO_CONTROLLER_LOG:GEN4_INIT_INT_LOG_ATmega328PB Return End

565 1764432105048 GEN4_TO_CONTROLLER_LOG:GEN4_INIT_INT_LOG_ATmega328PB Pre:GetInterfaceProvider
565 1764432105048 GEN4_TO_CONTROLLER_LOG:GEN4_INIT_INT_LOG_ATmega328PB Payload
565 1764432105048 GEN4_TO_CONTROLLER_LOG:GEN4_INIT_INT_LOG_ATmega328PB RI4DebugInterface
565 1764432105048 GEN4_TO_CONTROLLER_LOG:GEN4_INIT_INT_LOG_ATmega328PB Payload End
565 1764432105048 GEN4_TO_CONTROLLER_LOG:GEN4_INIT_INT_LOG_ATmega328PB Post:GetInterfaceProvider
565 1764432105048 GEN4_TO_CONTROLLER_LOG:GEN4_INIT_INT_LOG_ATmega328PB Return Value
565 1764432105048 GEN4_TO_CONTROLLER_LOG:GEN4_INIT_INT_LOG_ATmega328PB com.microchip.mplab.libs.atmelice.implementations.DebugInterface@2a863a95
565 1764432105048 GEN4_TO_CONTROLLER_LOG:GEN4_INIT_INT_LOG_ATmega328PB Return End

565 1764432105048 GEN4_TO_CONTROLLER_LOG:GEN4_INIT_INT_LOG_ATmega328PB Pre:GetInterfaceProvider
565 1764432105048 GEN4_TO_CONTROLLER_LOG:GEN4_INIT_INT_LOG_ATmega328PB Payload
565 1764432105048 GEN4_TO_CONTROLLER_LOG:GEN4_INIT_INT_LOG_ATmega328PB RI4ProgramInterface
565 1764432105048 GEN4_TO_CONTROLLER_LOG:GEN4_INIT_INT_LOG_ATmega328PB Payload End
565 1764432105048 GEN4_TO_CONTROLLER_LOG:GEN4_INIT_INT_LOG_ATmega328PB Post:GetInterfaceProvider
565 1764432105048 GEN4_TO_CONTROLLER_LOG:GEN4_INIT_INT_LOG_ATmega328PB Return Value
565 1764432105048 GEN4_TO_CONTROLLER_LOG:GEN4_INIT_INT_LOG_ATmega328PB com.microchip.mplab.libs.atmelice.implementations.ProgramInterface@6c6bcd5f
565 1764432105048 GEN4_TO_CONTROLLER_LOG:GEN4_INIT_INT_LOG_ATmega328PB Return End

565 1764432105049 GEN4_TO_CONTROLLER_LOG:GEN4_INIT_INT_LOG_ATmega328PB Pre:GetInterfaceProvider
565 1764432105049 GEN4_TO_CONTROLLER_LOG:GEN4_INIT_INT_LOG_ATmega328PB Payload
565 1764432105049 GEN4_TO_CONTROLLER_LOG:GEN4_INIT_INT_LOG_ATmega328PB RI4ConnectInterface
565 1764432105049 GEN4_TO_CONTROLLER_LOG:GEN4_INIT_INT_LOG_ATmega328PB Payload End
565 1764432105049 GEN4_TO_CONTROLLER_LOG:GEN4_INIT_INT_LOG_ATmega328PB Post:GetInterfaceProvider
565 1764432105049 GEN4_TO_CONTROLLER_LOG:GEN4_INIT_INT_LOG_ATmega328PB Return Value
565 1764432105049 GEN4_TO_CONTROLLER_LOG:GEN4_INIT_INT_LOG_ATmega328PB com.microchip.mplab.libs.atmelice.implementations.ConnectInterface@1438f014
565 1764432105049 GEN4_TO_CONTROLLER_LOG:GEN4_INIT_INT_LOG_ATmega328PB Return End

565 1764432105049 GEN4_TO_CONTROLLER_LOG:GEN4_INIT_INT_LOG_ATmega328PB Pre:GetInterfaceProvider
565 1764432105049 GEN4_TO_CONTROLLER_LOG:GEN4_INIT_INT_LOG_ATmega328PB Payload
565 1764432105049 GEN4_TO_CONTROLLER_LOG:GEN4_INIT_INT_LOG_ATmega328PB RI4ControllerDiagnosticsInterface
565 1764432105049 GEN4_TO_CONTROLLER_LOG:GEN4_INIT_INT_LOG_ATmega328PB Payload End
565 1764432105049 GEN4_TO_CONTROLLER_LOG:GEN4_INIT_INT_LOG_ATmega328PB Post:GetInterfaceProvider
565 1764432105049 GEN4_TO_CONTROLLER_LOG:GEN4_INIT_INT_LOG_ATmega328PB Return Value
565 1764432105049 GEN4_TO_CONTROLLER_LOG:GEN4_INIT_INT_LOG_ATmega328PB com.microchip.mplab.libs.atmelice.implementations.UnimplementedDiagnostics@432a0c70
565 1764432105049 GEN4_TO_CONTROLLER_LOG:GEN4_INIT_INT_LOG_ATmega328PB Return End

565 1764432105049 GEN4_TO_CONTROLLER_LOG:GEN4_INIT_INT_LOG_ATmega328PB Pre:GetInterfaceProvider
565 1764432105049 GEN4_TO_CONTROLLER_LOG:GEN4_INIT_INT_LOG_ATmega328PB Payload
565 1764432105049 GEN4_TO_CONTROLLER_LOG:GEN4_INIT_INT_LOG_ATmega328PB ProgrammerToGo
565 1764432105049 GEN4_TO_CONTROLLER_LOG:GEN4_INIT_INT_LOG_ATmega328PB Payload End
565 1764432105049 GEN4_TO_CONTROLLER_LOG:GEN4_INIT_INT_LOG_ATmega328PB Post:GetInterfaceProvider
565 1764432105049 GEN4_TO_CONTROLLER_LOG:GEN4_INIT_INT_LOG_ATmega328PB Return Value
565 1764432105049 GEN4_TO_CONTROLLER_LOG:GEN4_INIT_INT_LOG_ATmega328PB null
565 1764432105049 GEN4_TO_CONTROLLER_LOG:GEN4_INIT_INT_LOG_ATmega328PB Return End

565 1764432105049 GEN4_TO_CONTROLLER_LOG:GEN4_INIT_INT_LOG_ATmega328PB Pre:GetInterfaceProvider
565 1764432105049 GEN4_TO_CONTROLLER_LOG:GEN4_INIT_INT_LOG_ATmega328PB Payload
565 1764432105049 GEN4_TO_CONTROLLER_LOG:GEN4_INIT_INT_LOG_ATmega328PB Status
565 1764432105049 GEN4_TO_CONTROLLER_LOG:GEN4_INIT_INT_LOG_ATmega328PB Payload End
565 1764432105049 GEN4_TO_CONTROLLER_LOG:GEN4_INIT_INT_LOG_ATmega328PB Post:GetInterfaceProvider
565 1764432105049 GEN4_TO_CONTROLLER_LOG:GEN4_INIT_INT_LOG_ATmega328PB Return Value
565 1764432105049 GEN4_TO_CONTROLLER_LOG:GEN4_INIT_INT_LOG_ATmega328PB null
565 1764432105049 GEN4_TO_CONTROLLER_LOG:GEN4_INIT_INT_LOG_ATmega328PB Return End

565 1764432105053 GEN4_TO_CONTROLLER_LOG:GEN4_CONNECT_INT_LOG Pre:EstablishCommunincations
565 1764432105053 GEN4_TO_CONTROLLER_LOG:GEN4_CONNECT_INT_LOG Payload
565 1764432105053 GEN4_TO_CONTROLLER_LOG:GEN4_CONNECT_INT_LOG com.microchip.mplab.mdbcore.AtmelIceScripting.AIceScriptingCom@58e3d412
565 1764432105053 GEN4_TO_CONTROLLER_LOG:GEN4_CONNECT_INT_LOG Payload End
565 1764432105053 NativeController::EstablishCommunincations entry
565 1764432105053 pro JtagIce3 [0x00] <<< 00 00 00 
565 1764432105074 pro JtagIce3 [0x00] >>> 81 00 00 01 12 20 11 
565 1764432105074 pro JtagIce3 [0x01] <<< 10 00 
565 1764432105089 pro JtagIce3 [0x01] >>> 80 00 
565 1764432105089 pro JtagIce3 [0x00] <<< 00 00 03 
565 1764432105106 pro JtagIce3 [0x00] >>> 81 00 01 05 
565 1764432105106 NativeController::EstablishCommunincations exit
565 1764432105106 GEN4_TO_CONTROLLER_LOG:GEN4_CONNECT_INT_LOG Post:EstablishCommunincations
565 1764432105106 GEN4_TO_CONTROLLER_LOG:GEN4_CONNECT_INT_LOG Return Value
565 1764432105106 GEN4_TO_CONTROLLER_LOG:GEN4_CONNECT_INT_LOG true
565 1764432105106 GEN4_TO_CONTROLLER_LOG:GEN4_CONNECT_INT_LOG Return End

565 1764432105106 GEN4_TO_CONTROLLER_LOG:GEN4_CONNECT_INT_LOG Pre:GetFirmwareInfo
565 1764432105106 GEN4_TO_CONTROLLER_LOG:GEN4_CONNECT_INT_LOG Payload
565 1764432105106 GEN4_TO_CONTROLLER_LOG:GEN4_CONNECT_INT_LOG null
565 1764432105106 GEN4_TO_CONTROLLER_LOG:GEN4_CONNECT_INT_LOG Payload End
565 1764432105106 NativeController::GetFirmwareInfo entry
565 1764432105106 pro JtagIce3 [0x01] <<< 02 00 00 00 01 
565 1764432105121 pro JtagIce3 [0x01] >>> 84 01 00 00 
565 1764432105121 NativeController::getFirmwareVersion entry
565 1764432105121 pro JtagIce3 [0x01] <<< 02 00 00 01 01 
565 1764432105137 pro JtagIce3 [0x01] >>> 84 01 01 00 
565 1764432105137 pro JtagIce3 [0x01] <<< 02 00 00 02 01 
565 1764432105153 pro JtagIce3 [0x01] >>> 84 01 16 00 
565 1764432105154 pro JtagIce3 [0x01] <<< 02 00 00 03 02 
565 1764432105169 pro JtagIce3 [0x01] >>> 84 01 86 00 00 
565 1764432105169 NativeController::getFirmwareVersion exit
565 1764432105169 pro JtagIce3 [0x01] <<< 02 00 00 09 01 
565 1764432105186 pro JtagIce3 [0x01] >>> 84 01 FF 00 
565 1764432105186 NativeController::tryGetFPGAVersion entry
565 1764432105186 pro JtagIce3 [0x01] <<< 02 00 00 10 01 
565 1764432105201 pro JtagIce3 [0x01] >>> 84 01 00 11 
565 1764432105202 pro JtagIce3 [0x01] <<< 02 00 00 11 01 
565 1764432105218 pro JtagIce3 [0x01] >>> 84 01 00 11 
565 1764432105218 pro JtagIce3 [0x01] <<< 02 00 00 12 01 
565 1764432105233 pro JtagIce3 [0x01] >>> 84 01 00 11 
565 1764432105234 NativeController::tryGetFPGAVersion exit
565 1764432105234 NativeController::tryGetFPGAVersion exit with exception No value present
565 1764432105234 pro JtagIce3 [0x01] <<< 02 00 00 06 01 
565 1764432105249 pro JtagIce3 [0x01] >>> 84 01 01 00 
565 1764432105249 pro JtagIce3 [0x01] <<< 02 00 00 07 01 
565 1764432105266 pro JtagIce3 [0x01] >>> 84 01 00 00 
565 1764432105266 pro JtagIce3 [0x01] <<< 02 00 00 0A 01 
565 1764432105281 pro JtagIce3 [0x01] >>> 84 01 00 11 
565 1764432105282 NativeController::GetFirmwareInfo exit
565 1764432105282 GEN4_TO_CONTROLLER_LOG:GEN4_CONNECT_INT_LOG Post:GetFirmwareInfo
565 1764432105282 GEN4_TO_CONTROLLER_LOG:GEN4_CONNECT_INT_LOG Return Value
565 1764432105282 GEN4_TO_CONTROLLER_LOG:GEN4_CONNECT_INT_LOG FirmwareInfo: Values:
565 1764432105282 GEN4_TO_CONTROLLER_LOG:GEN4_CONNECT_INT_LOG FirmwareInfo: boot = false, bootVer = 1.0.0 (0x01.0x00.0x00), apVer = 1.22.134 (0x01.0x16.0x86), fpgaVer = null, scriptVer = null, macAddress = , devID = 0, devID1 = 0, devSN0 = 0, devSN1 = 0, serialNumber = null, appCommitID = null, scriptCommitID = null, PCB_ID = 0
565 1764432105282 GEN4_TO_CONTROLLER_LOG:GEN4_CONNECT_INT_LOG Return End
565 1764432105282 GEN4_CONNECT_DIAGNOSTICS:ENTERING: com.microchip.mplab.mdbcore.RI4Tool.ConnectionHandler.CheckForFWUpdates()
565 1764432105282 GEN4_CONNECT_DIAGNOSTICS:Created FirmwareUpdateHandler com.microchip.mplab.mdbcore.AtmelIceScripting.OperationHandlers.AIceScriptingFirmwareUpdateHandler@6a50eb64

565 1764432105288 GEN4_TO_CONTROLLER_LOG:GEN4_CONNECT_INT_LOG Pre:SetUpdateFirmwareInfo
565 1764432105288 GEN4_TO_CONTROLLER_LOG:GEN4_CONNECT_INT_LOG Payload
565 1764432105288 GEN4_TO_CONTROLLER_LOG:GEN4_CONNECT_INT_LOG UpdateFirmwareInfo: Values:
565 1764432105288 GEN4_TO_CONTROLLER_LOG:GEN4_CONNECT_INT_LOG UpdateFirmwareInfo: license = , updateId = 255
565 1764432105288 GEN4_TO_CONTROLLER_LOG:GEN4_CONNECT_INT_LOG Payload End
565 1764432105288 GEN4_TO_CONTROLLER_LOG:GEN4_CONNECT_INT_LOG Post:SetUpdateFirmwareInfo
565 1764432105288 GEN4_TO_CONTROLLER_LOG:GEN4_CONNECT_INT_LOG Return Value
565 1764432105288 GEN4_TO_CONTROLLER_LOG:GEN4_CONNECT_INT_LOG none
565 1764432105288 GEN4_TO_CONTROLLER_LOG:GEN4_CONNECT_INT_LOG Return End
565 1764432105288 GEN4_CONNECT_DIAGNOSTICS:EXITING: com.microchip.mplab.mdbcore.RI4Tool.ConnectionHandler.CheckForFWUpdates()

565 1764432105288 GEN4_TO_CONTROLLER_LOG:GEN4_CONNECT_INT_LOG Pre:SetPowerInfo
565 1764432105288 GEN4_TO_CONTROLLER_LOG:GEN4_CONNECT_INT_LOG Payload
565 1764432105288 GEN4_TO_CONTROLLER_LOG:GEN4_CONNECT_INT_LOG PowerInfo: Values:
565 1764432105288 GEN4_TO_CONTROLLER_LOG:GEN4_CONNECT_INT_LOG PowerInfo: shotDownSystem = false, isToolPower = false, voltage = 5.000000, useVppFirst = false, useLowVoltageProgramming = true, useMaintainActivePower = false
565 1764432105288 GEN4_TO_CONTROLLER_LOG:GEN4_CONNECT_INT_LOG Payload End
565 1764432105288 NativeController::GetVoltageInfo entry
565 1764432105288 pro JtagIce3 [0x01] <<< 02 00 01 00 02 
565 1764432105306 pro JtagIce3 [0x01] >>> 84 01 88 13 00 
565 1764432105306 pro JtagIce3 [0x01] <<< 02 00 01 20 02 
565 1764432105322 pro JtagIce3 [0x01] >>> 84 01 00 00 11 
565 1764432105322 NativeController::GetVoltageInfo TSUP exit with exception + The requested command is not supported. (17)
565 1764432105322 pro JtagIce3 [0x01] <<< 02 00 01 02 02 
565 1764432105337 pro JtagIce3 [0x01] >>> 84 01 00 00 11 
565 1764432105337 NativeController::GetVoltageInfo VUSB exit with exception + The requested command is not supported. (17)
565 1764432105337 NativeController::GetVoltageInfo exit
565 1764432105337 GEN4_TO_CONTROLLER_LOG:GEN4_CONNECT_INT_LOG Post:SetPowerInfo
565 1764432105337 GEN4_TO_CONTROLLER_LOG:GEN4_CONNECT_INT_LOG Return Value
565 1764432105337 GEN4_TO_CONTROLLER_LOG:GEN4_CONNECT_INT_LOG none
565 1764432105337 GEN4_TO_CONTROLLER_LOG:GEN4_CONNECT_INT_LOG Return End

565 1764432105337 GEN4_TO_CONTROLLER_LOG:GEN4_CONNECT_INT_LOG Pre:GetVoltageInfo
565 1764432105337 GEN4_TO_CONTROLLER_LOG:GEN4_CONNECT_INT_LOG Payload
565 1764432105337 GEN4_TO_CONTROLLER_LOG:GEN4_CONNECT_INT_LOG null
565 1764432105337 GEN4_TO_CONTROLLER_LOG:GEN4_CONNECT_INT_LOG Payload End
565 1764432105337 NativeController::GetVoltageInfo entry
565 1764432105337 pro JtagIce3 [0x01] <<< 02 00 01 00 02 
565 1764432105353 pro JtagIce3 [0x01] >>> 84 01 88 13 00 
565 1764432105353 pro JtagIce3 [0x01] <<< 02 00 01 20 02 
565 1764432105369 pro JtagIce3 [0x01] >>> 84 01 00 00 11 
565 1764432105370 NativeController::GetVoltageInfo TSUP exit with exception + The requested command is not supported. (17)
565 1764432105370 pro JtagIce3 [0x01] <<< 02 00 01 02 02 
565 1764432105385 pro JtagIce3 [0x01] >>> 84 01 00 00 11 
565 1764432105385 NativeController::GetVoltageInfo VUSB exit with exception + The requested command is not supported. (17)
565 1764432105385 NativeController::GetVoltageInfo exit
565 1764432105385 GEN4_TO_CONTROLLER_LOG:GEN4_CONNECT_INT_LOG Post:GetVoltageInfo
565 1764432105385 GEN4_TO_CONTROLLER_LOG:GEN4_CONNECT_INT_LOG Return Value
565 1764432105385 GEN4_TO_CONTROLLER_LOG:GEN4_CONNECT_INT_LOG VoltagesInfo: Values:
565 1764432105385 GEN4_TO_CONTROLLER_LOG:GEN4_CONNECT_INT_LOG VoltagesInfo: internalVdd = 0, internalVpp = 0, targetVdd = 0, targetVpp = -2147483648, vddSense = 5000, temp = 0, vddCurrentSense = 0, vddVoltageSense = -2147483648
565 1764432105385 GEN4_TO_CONTROLLER_LOG:GEN4_CONNECT_INT_LOG Return End

565 1764432105385 GEN4_TO_CONTROLLER_LOG:GEN4_CONNECT_INT_LOG Pre:SetLEDBrightness
565 1764432105385 GEN4_TO_CONTROLLER_LOG:GEN4_CONNECT_INT_LOG Payload
565 1764432105385 GEN4_TO_CONTROLLER_LOG:GEN4_CONNECT_INT_LOG 5
565 1764432105385 GEN4_TO_CONTROLLER_LOG:GEN4_CONNECT_INT_LOG Payload End
565 1764432105385 GEN4_TO_CONTROLLER_LOG:GEN4_CONNECT_INT_LOG Post:SetLEDBrightness
565 1764432105385 GEN4_TO_CONTROLLER_LOG:GEN4_CONNECT_INT_LOG Return Value
565 1764432105385 GEN4_TO_CONTROLLER_LOG:GEN4_CONNECT_INT_LOG none
565 1764432105385 GEN4_TO_CONTROLLER_LOG:GEN4_CONNECT_INT_LOG Return End

565 1764432105385 GEN4_TO_CONTROLLER_LOG:GEN4_CONNECT_INT_LOG Pre:SetToolInfo
565 1764432105385 GEN4_TO_CONTROLLER_LOG:GEN4_CONNECT_INT_LOG Payload
565 1764432105385 GEN4_TO_CONTROLLER_LOG:GEN4_CONNECT_INT_LOG ToolInfo: Values:
565 1764432105385 GEN4_TO_CONTROLLER_LOG:GEN4_CONNECT_INT_LOG ToolInfo: speedLevel = 1, PGCResistance = 4700, PGDResistance = 4700, PGCPullDir = PullDown, PGDPullDir = PullDown, ICSPSelected = Wire2
565 1764432105385 GEN4_TO_CONTROLLER_LOG:GEN4_CONNECT_INT_LOG Payload End
565 1764432105385 GEN4_TO_CONTROLLER_LOG:GEN4_CONNECT_INT_LOG Post:SetToolInfo
565 1764432105385 GEN4_TO_CONTROLLER_LOG:GEN4_CONNECT_INT_LOG Return Value
565 1764432105385 GEN4_TO_CONTROLLER_LOG:GEN4_CONNECT_INT_LOG none
565 1764432105385 GEN4_TO_CONTROLLER_LOG:GEN4_CONNECT_INT_LOG Return End

565 1764432105386 GEN4_TO_CONTROLLER_LOG:GEN4_CONNECT_INT_LOG Pre:GetTargetIDInfo
565 1764432105386 GEN4_TO_CONTROLLER_LOG:GEN4_CONNECT_INT_LOG Payload
565 1764432105386 GEN4_TO_CONTROLLER_LOG:GEN4_CONNECT_INT_LOG null
565 1764432105386 GEN4_TO_CONTROLLER_LOG:GEN4_CONNECT_INT_LOG Payload End
565 1764432105386 NativeController::GetTargetIDInfo entry
565 1764432105387 pro JtagIce3 [0x12] <<< 01 00 00 00 01 01 
565 1764432105402 pro JtagIce3 [0x12] >>> 80 00 
565 1764432105402 pro JtagIce3 [0x12] <<< 01 00 00 01 04 01 00 00 00 
565 1764432105418 pro JtagIce3 [0x12] >>> 80 00 
565 1764432105418 pro JtagIce3 [0x12] <<< 01 00 01 00 01 01 
565 1764432105434 pro JtagIce3 [0x12] >>> 80 00 
565 1764432105434 pro JtagIce3 [0x11] <<< 1D 7D 00 
565 1764432105450 pro JtagIce3 [0x11] >>> 1D 00 
565 1764432105450 pro JtagIce3 [0x11] <<< 10 C8 64 19 20 00 53 03 AC 53 00 00 
565 1764432105553 pro JtagIce3 [0x11] >>> 10 00 
565 1764432105553 pro JtagIce3 [0x11] <<< 1B 04 30 00 00 00 
565 1764432105570 pro JtagIce3 [0x11] >>> 1B 00 53 00 
565 1764432105570 pro JtagIce3 [0x11] <<< 1B 04 30 00 01 00 
565 1764432105586 pro JtagIce3 [0x11] >>> 1B 00 53 00 
565 1764432105586 pro JtagIce3 [0x11] <<< 1B 04 30 00 02 00 
565 1764432105602 pro JtagIce3 [0x11] >>> 1B 00 53 00
