upenn-embedded/final-project-website-submission-f25-t24-f25-team-1-team_name/ESP32_lichess/network_stuff.h

#ifndef NETWORK_STUFF_H
#define NETWORK_STUFF_H

#define WIFI_SSID "iFhone"
#define WIFI_PASS "4Fatredsheep"
#define LICHESS_API_TOKEN "lip_q5WzbKshAtF8cU4vIHNh"
#define LICHESS_USER "ayu2126"  
#endif
